farzamjahani/MachineDesign/matlab files/ComponentNames.txt

B12 B12 B13
B12 B12 B13
B12 GB GD
GA GB GD
GA GB GD
GA GC B23
B21 GC B23
B21 GC CG1
