farzamjahani/MachineDesign/GearBox.pdf

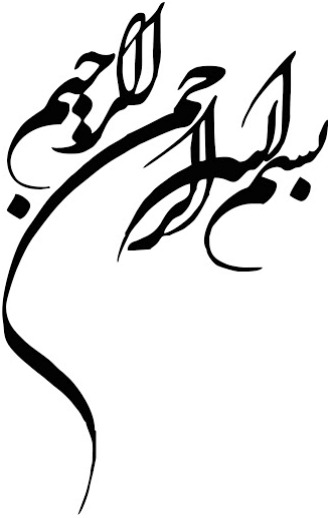
[picture p1: figure]

## گزارش پروژه

### عنوان پروژه:

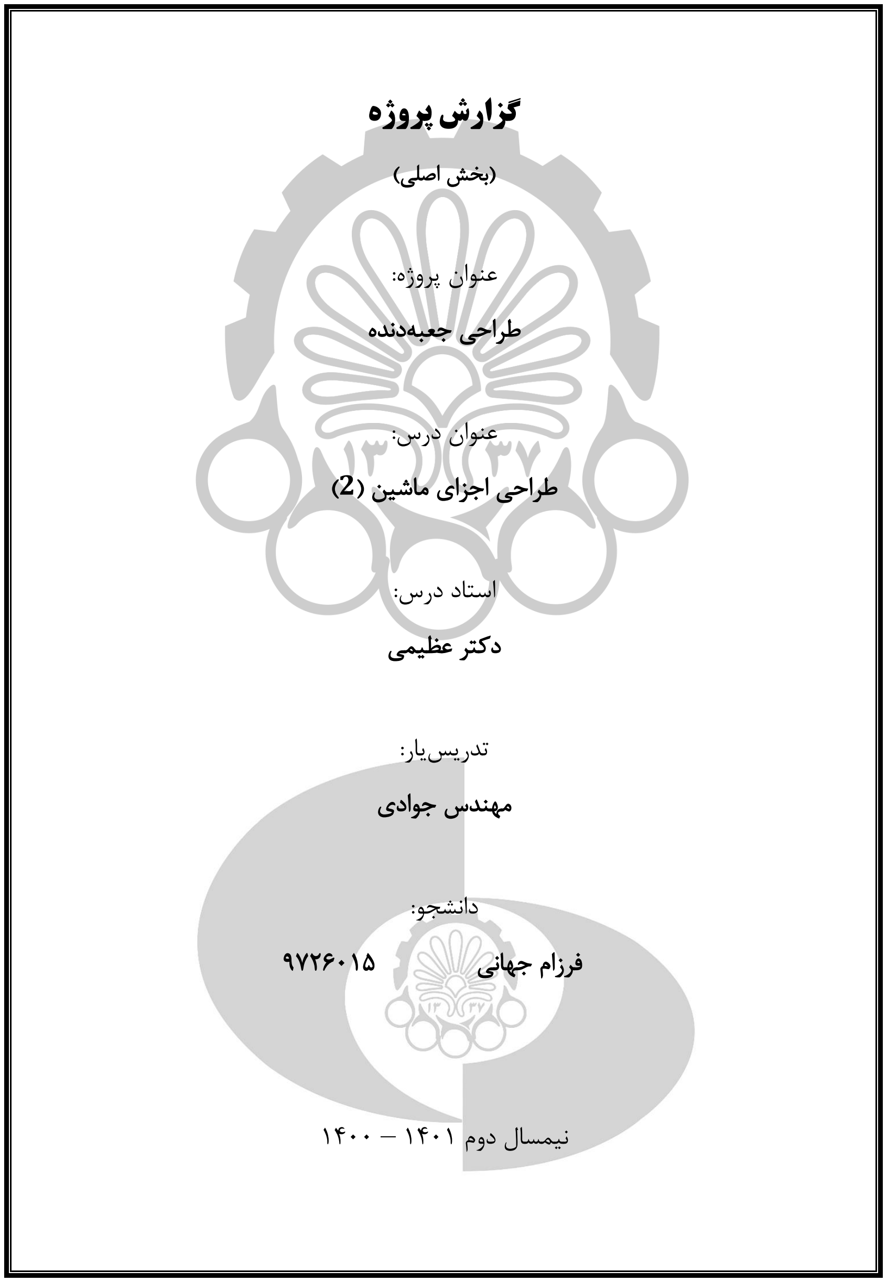
[picture p2: page 2]

)بخش اصلی(

### طراحی جعبه دنده

### عنوان درس: طراحی اجزای ماشین )2(

### استاد درس:

### دکتر عظیمی

### تدریسیار:

### مهندس جوادی

### دانشجو :

### فرزام جهانی 9726015

### نیمسال دوم 1401 – 1400

چکیده

### چکیده

با توجه به اهمیت سامانه های انتقال توان و نیرو در حوزه علم مکانیک، سامانه های متعددی نظیر جعبه دندهها معرفی شده اند. جعبه دندهها در اقسام متنوعی برحسب کاربرد ساخته میشوند. موضوع پروژه طراحی یک جعبه دنده سه محوره و دومرحله ای است. جعبه دنده ابزاری برای انتقال توان است که عمدتاً برای افزایش گشتاور مورد استفاده قرار می گیرد. قطعات بسیاری در این ابزار به کار گرفته می شود. چرخدنده، یاتاقان و شفت از اجزای حیاتی یک جعبه دنده هستند. این قطعات به همراه اجزای جانبی نظیر خارها به صورت تکتک طراحی گردیده، از آنان نقشه های ساخت تهیه شده و درنهایت به طور مناسب با یکدیگر مونتاژ خواهند شد. روش رایج برای طراحی های مکانیکی، طراحی برمبنای برآورده شدن استحکام الزم قطعات با فرض قطعیت کامل بوده و محاسبات آماری در این حالت وارد کار نخواه د شد. برای لحاظکردن و یا جبران عدم قطعیت در پارامترهای طراحی مانند عدم قطعیت در میزان بار وارده و خواص مواد، عاملی به نام ضریب اطمینان در طراحی جعبه دنده دخیل می گردد.

واژه های کلیدی

چرخدنده، شفت، خار، یاتاقان

فهرست مطالب

### فهرست مطالب

چک ی ده | أ
-1 فصل اول مقدمه 1 |
-2 فصل دوم داده ها و اطالعات 4 |
-3 فصل سوم فاز نخست پروژه 7 |
-4 فصل چهارم فاز دوم پروژه 12 |
-5 فصل پنجم فاز سوم پروژه 37 |
-6 فصل ششم خروجی نقشه ها 41 |

فصل اول: مقدمه

-1

## فصل اول مقدمه

فصل اول: مقدمه

### مقدمه

انسان همواره به دنبال تسهیلکردن امور روزمره است و برای انجام کارهایی که خارج از حد توانش باشند نیاز به افزایش توان دارد. بدین منظور از ماشینها و ابزارآالت استفاده می کند. امروزه برای انجام هرکاری به ماشین نیاز است. مهم ترین عضو یک ماشین، جعبه دنده آن است. تمام دستگاههای انتقال و افزایش قدرت دارای جعبه دنده هستند. جعبه دنده سازوکاری است که گشتاور ورودی را دریافت نموده، آن را افزایش داده و در قسمت خروجی تحویل می دهد. بنابر انتقال توان ثابت، افزایش گشتاور از طریق کاهش سرعت دورانی محور
1 | ورودی انجام می گیرد؛ لذا این نوع از جعبه دنده ها به جعبه دنده کاهنده
نامیده می شوند.
هدف از انجام پروژه طراحی یک جعبه دنده کاهنده دومرحلهای به همراه سامانه های ورودی و خروجی توان است. این جعبهدنده حامل سه محور )شفت( خواهد بود که محور ورودی آن، توان الکتروموتور را از طریق کوپلینگ وارد جعبه دنده نموده و پس از انجام دو مرحله کاهش سرعت به وسیله دو جفت چرخدنده مارپیچ، محور خروجی توان را برای مصرف خارج می گرداند. برای سامان دهی به فرایند طراحی این مجموعه پیچیده، در ابتدا نیاز است تا مراحل طراحی به چند فاز طراحی قطعات تقسیم بندی گردند. این کار عالوه بر تسهیل نمودن فرایند طراحی، به روش مند بودن انجام عملیات ها نیز کمک می کند. فازهای طبقه بندیشده شامل طراحی پنج بخش عمده طرح می شود که عبارت اند از:
- فاز اول: طراحی چرخدنده ها
- فاز دوم: طراحی شفت ها
- فاز سوم: انتخاب یاتاقان ها
- فاز چهارم: انتخاب کوپلینگ الزم به توضیح است که فرایند طراحی یک فرایند رفت و برگشتی است و به همین علت فازهای تفکیک شده به صورت مستقل در یک مسیر متوالی پیش نمی روند و بر یکدیگر تاثیر می گذارند. لذا برای شروع کار از فاز نخست شروع نموده و در مسیر انتقال توان به ترتیب فازها طی می شوند و در هر نقطه از مسیر طراحی امکان بازگشت به عقب برای تصحیح و یا بازبینی طرح وجود دارد.

1
reducer

فصل اول: مقدمه

شرح روش انجام پروژه
تمام محاسبات مورد نیاز در پروژه و سعی وخطاهای طراحی با استفاد ه از نرم افزار مهندسی MATLAB انجام گرفته است. استفاده از نرم افزار رایانه ای عالوه بر صرفه جویی در زمان ، موجب کاهش خطای انسانی و همچنین سرعت بخشیدن به فرایند انتخاب طرح مناسب نیز می شود. از طرفی نیز نباید نقش انسان به عنوان طراح به طور کامل نادیده گرفته شود؛ چرا که هیچ نرم افزاری نمی تواند جایگزین تفکر انسانی گردد. لذا فرایند طراحی در قالب یک برنامه تعاملی با کاربر انجام می گیرد؛ بدین صورت که پارامترهای پراهمیت در طراحی توسط برنامه از کاربر درخواست شده و با استفاده از آن محاسبات طراحی اجرا میگردد. درنهایت نتایج محاسبات به کاربر نمایش داده شده و با تصمیم وی روند طراحی ادامه می یابد. سعی شده است تا حد امکان برنامه طراحی پروژه عمومی باشد اما برای پرهیز از طوالنی شدن روند انجام پروژه و کاهش پیچیدگی های غیرضروری، ویژگی های مختص پروژه ِ پیش رو را پشتیبانی میکند. البته استفاده از رایانه برای انجام محاسبات میتواند روند طراحی را ماژوالر نماید؛ به طوری که با کمی تغییر در متن برنامه، آن را برای استفاده در سایر پروژه ها نیز معتبر می کند.

پس از انجام فرایند طراحی در هر فاز و دستیابی به طرح بهینه بعد از چندین بار سعی وخطای معقوالنه، نتایج خروجی از برنامه ثبت گردیده و پس از اعتبارسنجی آنان و بازبینی مجدد روند انجام پروژه، وارد مرحله نهایی سازی خواهد شد. در این مرحله ابعاد و اندازه های طرح به دست آمده و آماده تهیه نقشه های ساخت و مدلسازی سه بعدی خواهد بود که درنهایت این نقشه ها به همراه جزئیات برای ساخت ارسال می گردند. نرم افزار مورد استفاده در پروژه برای مدلسازی و تهیه نقشه ها، نرمافزار مدل سازی solidworks خواهد بود. فرض اساسی که در طول فرایند طراحی جعبه دنده در نظر گرفته شده است، نادیدهگرفتن تمام اتالف های مجموعه و لحاظ کردن بازدهی صد درصد برای کل قطعات درگیر در انتقال قدرت از موتور تا خروجی گیربکس است. کما اینکه به علت باال بودن بازدهی قطعات دندانه دار )نظیر چرخدنده ها(، این فرض معتبر خواهد بود. همچنین فرض می شود الکتروموتور متصل به دستگاه، به صورت تمام قدرت کار نموده و خاموش و روشن نمیشود.

فصل دوم: دادهها و اطالعات

-2

## فصل دوم داده ها و اطالعات

فصل دوم: دادهها و اطالعات

### داده ها و اطالعات

طرح نمادین یک جعبه دنده دومرحله ای به همراه دستگاه مختصات نظیرشده به آن، در شکل -2 1 نشان داده شده است. این جعبهدنده تک سرعته بوده و سامانه های انتقال توان در ورودی و خروجی آن به ترتیب به صورت مجموعه تسمه- قرقره و مجموعه زنجیر -چرخ زنجیر هستند. پیش از شروع طراحی الزم است تا قطعات و اجزای موجود در سامانه نامگذاری و توجیه گردند . بنابراین در مسیر جریان انتقال قدرت یعنی از موتور تا ابتدای مصرف کننده، ش فت ها، قرقره ها و چرخ زنجیرها به ترتیب تعداد با یک عدد، یاتاقانها به ترتیب تعداد بر روی هر شفت با دو عدد و چرخدندهها به ترتیب حروف الفبای انگلیسی نامیده می شوند. شیوه نامگذاری قطعات در راهنمای شکل -2 1 توضیح داده شده است.

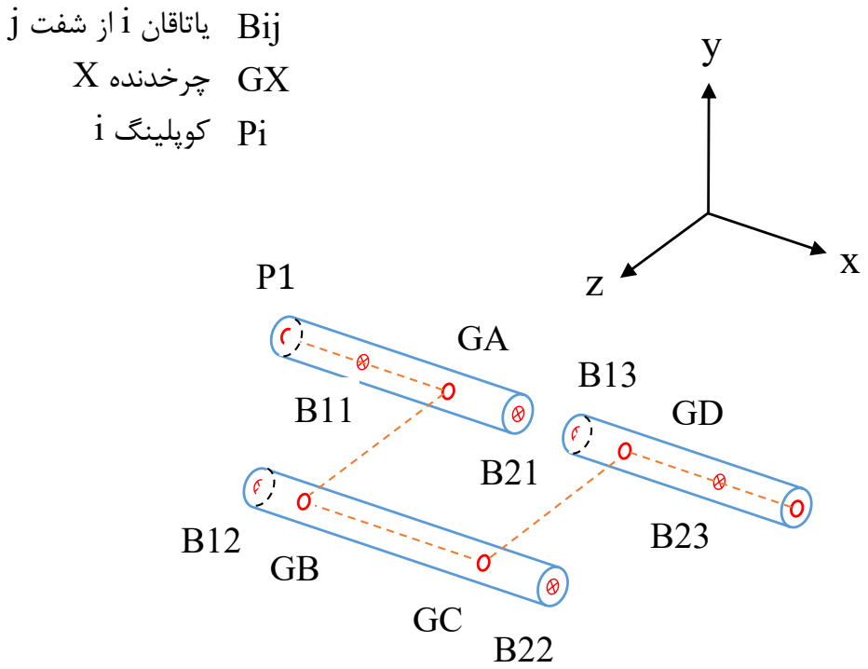
[picture p3: figure]
Bij یاتاقان i از شفت j; چرخدنده; کوپلینگ

شکل -1-2 طرح واره کلی از جعبه دنده

فصل دوم: دادهها و اطالعات

شرح داده ها و اطالعات

جعبه دنده توان را از یک موتور الکتریکی 1360 وات )باتوجه به شماره داشنجویی( در دور نامی 1450 دور بر دقیقه دریافت کرده و به شفت خروجی انتقال می دهد. نسبت تبدیل سرعت جعبه دند ة کاهنده در حدود 2% ± 11.9( باتوجه به شماره داشنجویی( است.

جعبه دنده و الکتروموتور آن دارای بارهای ضربه ای متوسط هستند که عمر مدنظر برای کل سامانه 10 سال در یک شیفت کاری لحاظ میشود. یک شیفت کاری معادل 8 ساعت در روز و هر سال مشتمل بر 300 روز کاری است.

ضریب اطمینان این مجموعه برابر 3 بر روی بار درنظر گرفته خواهد شد و قابل اطمینان مجموعه یاتاقان های این جعبه دنده حداقل %90 مورد انتظار است. در طراحی این مجموعه انتقال قدرت سعی می شود تا حد ممکن از پدیده شکارچی پرهیز شود. جعبه دنده توسط چهار پیچ اتصال به شاسی متصل می گردد و مطلوب این است که در کوچکترین اندازه طراحی شود.

تمامی چرخدندههای به کاررفته در این جعبه دنده از نوع مارپیچ با زاویه فشار نرمال 20 درجه هستند. به عالوه، زاویه مارپیچ دنده ها عددی صحیح در بازه 15 تا 30 درجه مطلوب است. جنس دنده چرخدنده ها از فوالد 4140 AISI و گرید 2 در نظر گرفته می شود. هم چنین میتوان عدد سختی برینل دنده های این چرخدندهها را تا 325 درنظر گرفت و با انجام سختکاری سطحی به سختی 50 RC رسید .

هر شفت درون این جعبه دنده با دو یاتاقان مهار می شود که محل قرارگیری آنان بر روی شفتها دلخواه است. یاتاقانها از نوع شیارعمیق یا متناسب با شرایط موجود می توانند از نوع غلتکی باش ند. منبع انتخاب یاتاقانهای سامانه از کاتالوگ SKF خواهد بود.

تمامی شفت ها از جنس 45CK هستند. این جنس که جزء جنسهای متداول شفت است، دارای استحکام حد نهایی برابر 660 مگاپاسکال و استحکام تسلیم برابر 470 مگاپاسکال خواهد بود. همچنین خارها همجنس با شفت و از نوع مربعی هستند.

فصل سوم: فاز اول پروژه طراحی چرخدندهها

-4

## فصل سوم فاز اول پروژه

فصل سوم: فاز اول پروژه طراحی چرخدندهها

### فاز اول پروژه )طراحی چرخدنده ها(

زیرسامانه چرخدنده ها در دو مرحله وظیفه افزایش بیشترین نسبت قدرت را در مجموعه بر عهده دارند. قلب تپنده یک جعبه دنده چرخدندههای آن است. انتقال توان با استفاده از چرخدنده ها مطمئنترین نوع انتقال توان است. هزینه ساخت چرخدندهها نسبت به سایر قطعات مشابه برای انتقال توان نسبتاً باالست. لذا اهمیت فوق العادهای در مجموعه پیدا می کنند. از میان اقسام پرشمار چرخدندهها، نوع مارپیچ آن به طور معمول در ساخت جعبهدنده استفاده میشود. چرخدندههای مارپیچ به نسبت چرخدندههای ساده در سرعتهای باال بار بیشتری تحمل می کنند و هم چنین تولید سروصدای کمتری نیز دارند. افزون بر این موارد، زاویه مارپیچ چرخدندههای آن ها نسبت به چرخدندههای ساده به عنوان پارامتری مهم در منعطف نمودن طراحی چرخدندهها تلقی می شود. در ازای این مزایا به علت مورب بودن دنده ها، چرخدندههای مارپیچ بار محوری بر شفت تحمیل می کنند. با تمام این تفاسیر در جعبه دنده مورد نظر از همین نوع چرخدنده بنابر خواسته کارفرما استفاده خواهد شد. معیار طراحی چرخدنده ها طبق روال معمول بر مبنای استاندارد AGMA خواهد بود. بدین طریق که طراحی چرخدنده بر مبنای سه اصل به ترتیب پرهیز از تداخل، تحلیل خستگی خمشی و تحلیل خستگی سطحی تحت شرایط عدم وجود پدیده شکارچی و رعایت محدوده نسبت تبدیل خواسته شده توسط کارفرما، انجام می گیرد.
با توجه به اینکه کارفرما درخواست طراحی کوچکترین حالت جعبه دنده را داده است، منطقاً برای دستیابی به این خواسته نسبت تبدیل هر دو مرحله کاهش سرعت در جعبه دنده، یکسان فرض می شود. حال اینکه قید همراستایی شفت ورودی و خروجی در پروژه وجود ندارد، آزادی در طراحی کمی بیشتر می شود اما با این وجود سعی می گردد عدم همراستایی شفت ورودی و خروجی در جعبه دنده تاحد ممک ن کم باشد . چراکه بیش از حد بودن عدم همراستایی شفتهای ورودی و خروجی جعبه دنده چندان مطلوب مشتری نیست. همین طور مدول انتخابی برای دنده ها از نوع ترجیحی گزینش خواهد شد و از انتخاب های بعدی برای مدول دنده ها استفاده نمی گردد.

فصل سوم: فاز اول پروژه طراحی چرخدندهها

شرح تابع طراحی چرخدنده
تابع طراحی زیرسامانه چرخدنده در قالب یک کد با نام HelicalGear تدوین شده است. این تابع ورودیهایی را دریافت نموده و با تعامل میان کاربر روند محاسبات و تکرارهای مورد نیاز این فاز را طی کرده و در نهایت نتیجه فرایند طراحی را به صورت خروجی های ماتریسی در اختیار فازهای بعدی پروژه قرار می دهد. ورودی های تابع چرخدنده بدین شرح هستند:
- توان نامی موتور برحسب وات
- دور نامی موتور برحسب دوربردقیقه
- ضریب اطمینان نهایی مجموعه فرایند طراحی هر مرحله کاهش سرعت برای هر جفت چرخدنده به صورت یک جا، متوالی و برمبنای سه اصل ذکرشده انجام می شود. در ابتدای محاسبات هر مرحله برای جفت چرخدندهها، زاویه مارپیچ دنده ها توسط کاربر وارد مسیر برنامه شده و به دنبال آن، تعداد چرخه )سیکل( چرخدنده محرک، زاویه فشار ظاهری و حداقل تعداد دندانه های چرخدنده محرک برای پرهیز از تداخل محاسبه می گردد. پس از آن برای دستیابی به تعداد دندانه های مناسب چرخدنده متحرک فرایندی تکراری انجام گرفته، دو شرط پرهیز از شکارچی شدن و رعایت بازه نسبت تبدیل درخواستی کارفرما بررسی شده و در صورت صادق بودن این قیود، برنامه با تعیین تعداد دندانه های مناسب برای هردو چرخدنده درگیر، از حلقه تکرار اول خارج می گردد. در حلقه اول برنامه این امکان را دارد که به صورت موضعی قبل از طراحی مرحله دوم، بر مبنای فرض یکسان در نظر گرفتن نسبت تبدیل، عدم رعایت نسبت تبدیل درخواستی کارفرما را به کاربر اطالع دهد. برای تحلیل خستگی خمشی دنده ها، پس از انجام محاسبات اولیه و وارد کردن اطالعات مورد نیاز توسط کاربر اعم از قابلیت اطمینان و نسبت پهنای دنده، برنامه وارد دو حلقه تکرار تودرتو شده تا حداقل مدول نرمال دنده ها با رعایت تمام شروطِ نامبرده حاصل شود. در ابتدای حلقه اول و پیش از ورود به حلقه دوم برمبنای اطالع از پهنای دنده و به کمک جدول 15-2 ] 2[ ، برنامه ضریب توزیع بار را وارد جریان محاسبات می کند. درون حلقه دوم با ورود یک مدول حدسی توسط کاربر، ضریب دینامیکی محاسبه شده و با دردست داشتن تمام ضرایب، حداقل مدول نرمال دنده حاصل می گردد و از کاربر تقاضا می شود مدول حاصلشده را با کمک مقادیر ترجیحی از جدول 13-2 ] 1[ تصحیح کند. با همگرایی مدول حدسی و مدول تصحیح شده توسط کاربر، برنامه حلقه درونی را ترک می کند.

فصل سوم: فاز اول پروژه طراحی چرخدندهها

برای تحلیل خستگی سطحی نیز مشابه قسمت تحلیل خستگی خمشی، تمام مراحل اجرا گردیده با این تفاوت که مدول شروع کار، همان مدول به دست آمده از تحلیل خستگی خمشی خواهد بود. مدول نرمال اولیه برای محاسبه ضریب هندسی دنده ها الزم است. به روال معمول در حلقه داخلی دوم نیز با همگرا شدن روند تکرار بر روی مدول نرمال، حلقه تکرار پایان می یابد. مدول نهایی هر جفت چرخدنده برابر بیشینه حد دو مدول نرمال محاسبه شده انتخاب میشود. در این حالت با داشتن مدول نرمال، پهنای دنده قابل حصول است و برنامه به ابتدای حلقه تکرار خارجی باز می گردد و براساس پهنای دنده، ضریب توزیع بار را مجدداً به روز می کند و در صورت تفاوت داشتن این ضریب، حلقه های داخلی تکرار می شوند و درغیر این صورت، برنامه با موفقیت حلقه های تکرار مدول یابی را خاتمه می دهد. پس از نهایی شدن مدول نرمال، پهنای دنده، فاصله مرکزتامرکز چرخدنده ها، قطرهای گام و ریشه هر چرخدنده از هر جفت محاسبه می شوند. قطر ریشه دنده ها برای تحلیل ضریب طوقه به کار می رود. بعد از اتمام طراحی هر دو مرحله، بار دیگر نسبت تبدیل نهایی جعبه دنده )حاصل از هر دو مرحله( چک شده و در صورت عدم رعایت بازه درخواستی کارفرما، پیغام هشدار برای کاربر ظاهر می گردد و می بایست فرایند طراحی فوق مجدداً اجرا شود.
خروجی های تابع چرخدنده برای هر مرحله )جفت چرخدنده( به شرح زیر هستند:
- تعداد دندانه چرخدنده ها
- نسبت تبدیل هر مرحله
- پهنای دنده ها برحسب میلی متر
- فاصله مرکزتامرکز چرخدنده ها برحسب میلی متر
- مدول نرمال برحسب میلی متر
- قطرهای گام و ریشه چرخدندهها برحسب میلی متر
- مشخصات دنده شامل قطرهای گام و زاویه مارپیچ چرخدندهها خروجی های تابع چرخدنده در قالب مقادیر ماتریسی برای فازهای بعدی طراحی ارسال می شوند.

فصل سوم: فاز اول پروژه طراحی چرخدندهها

نتیجه نهایی فاز دوم برای طراحی چرخدندههای مارپیچ در جدول -4 1 ثبت شده است.

جدول -1-4 مشخصات زیرسامانه چرخدنده های مارپیچ
| | | پارامتر مرحله اول مرحله دوم نماد
p | | | تعداد دندانه های pinion 13 13 N
g | | | تعداد دندانه های gear 45 45 N
− | left−hand | right−hand | pinion های دنده نوع
− | right−hand | left−hand | gear های دنده نوع
m n | 4 mm | 3 mm | نرمال مدول
ψ | 20° | 20° | مارپیچ زاویه
| | .4615 3.4615 ~ mG | نسبت تبدیل 3 ~
| | | پهنای دنده ها mm 24 mm 48 b
C | ~ 123.44 mm | ~ 92.58 mm | ها چرخدنده مرکزتامرکز HG
| ~ 55.33 mm | ~ 41 .5 mm | pinion گام قطر d
| ~ 191.55 mm | ~ 143 .66 mm | gear گام قطر D
d r | ~ 45.3 mm | ~ 34 mm | pinion ریشه قطر
D r | ~ 181.55 mm | ~ 136.16 mm | gear ریشه قطر
| .981 HG,TR | | نسبت تبدیل نهایی 11 ~
− | ~ 0.19% | | میزان خطا ی نسبت تبدیل جعبه دنده
− | ~ 30.86 mm | | میزان عد م همراستایی شفت ورودی و خروجی

فصل چهارم: فاز دوم پروژه طراحی شفت ها

-6

## فصل چهارم فاز دوم پروژه

### فاز دوم پروژه )طراحی شفت های جعبه دنده(

شفتهای یک جعبه دنده وظیفه انتقال توان از میان قطعات درگیر را بر عهده دارند. همچنین نیروهای اعمالی از طرف قطعات را به یاتاقان های مجموعه منتقل می کنند. حیاتی ترین و بحرانی ترین قطعات در جعبه دنده، شفتها هستند؛ زیرا به علت دوران، شدیداً تحت تاثیر اثرات خستگی، به دلیل مقاطع مختلف و جای خارها به شدت تحت اثرات تمرکز تنشی و هم چنین در معرض انواع بارگذاری ها از قبیل خمشی، برشی، پیچشی و محوری قرار دارند.
فرایند طراحی شفت به میزان بیشتری نسبت سایر قطعاتِ طراحی شده به تکرار و سعیو خطا نیاز دارد. برای تعیین معادالت، تنها اثرات خستگی در نوع بارگذاری خمشی و پیچشی بررسی می شود و از اثرات برشی نیروهای برشی صرف نظر خواهد شد. هم چنین زمانی که خمش در شفت حضور دارد، اثرات تنش محوری نیروی محوری ناشی از چرخدنده مارپیچ )یا یاتاقان مخروطی( ناچیز است و می توان از آن چشم پوشی نمود.
1 | بنابراین بارگذاری خمشی در شفت به صورت متناوب
)اندازه بیشینه و کمینه خمش یکسان( و بارگذاری
2 | پیچشی به صورت مکرر
)کمینه پیچش برابر صفر( لحاظ خواهد شد.
طراحی شفت های جعبه دنده در دو بخش انجام می گیرد؛ 1( محاسبه نیروهای تکیه گاهی و توزیع گشتاور خمشی در شفت 2( تعیین قطر مقاطع شفت و طراحی خارهای قطعات

1
completely reversed loading

2
repeated loading

-1 محاسبه نیروهای تکیه گاهی و توزیع گشتاور خمشی در شفت

برای محاسبه نیروهای تکیه گاهی و گشتاور خمشی در شفت نیاز است تا فواصل میان قطعات نصبشده بر روی شفت، پهنای قطعات و هم چنین طول نهایی شفت مشخص باشد اما در حال حاضر این اطالعات در دسترس نیستند. بنابراین با تکیه بر فرضیات و استفاده از طرح های ساختهشده میتوان تخمینی از این ابعاد به دست آورد، با آن فرایند طراحی را به پیش برد و طی چندین مرحله سعی وخطا بر روی انواع پرشماری از متغیرها، به طرحی معقول دست یافت. عمده فرضیات مقدماتی برای دستیابی به طرح اولیه شفت ها از این قرار هستند: با تحلیل کاتالوگ SKF می توان مالحظه نمود یاتاقان های شیارعمیق و غلتک استوانهای در قطرهای 15 تا 50 میلی متر دارا ی حداکثر پهنای 20 میلی متر خواهند بود. لذا با لحاظ کردن بدترین حالت و با توجه به اینکه قطر مقاطع شفت در این جعبه مورد نظر حداکثر در حدود 50 میلی متر خواهد بود، پهنای یاتاقان ها برابر 20 میلی متر درنظر گرفته می شود. )روش طراحی برمبنای بدترین حالت، روش مناسبی برای طراحی نیست اما می تواند حد نهایی برخی پارامترهای طراحی را مشخص نماید( میان لبه پله و جای خار فنری و همین طور برای طول پله وسط شفت های ورودی و خروجی فاصله ای به اندازه 10 میلی متر منظور می گردد. طول پله وسط شفت میانی با توجه به مالحظات قرارگیری یاتاقان های دو شفت ورودی و خروجی و با کمک ابعاد تخمینی برابر 80 میلی متر لحاظ می شود. با بررسی ابعاد قطعات منتقل کننده توان و توجه به پهنای نسبتاً زیاد چرخدنده ها ، نیاز این قطعات به نافی محسوس و منطقی نیست لذا جایی برای نافی لحاظ نمی شود )شایان ذکر است تمام شفت های مجموعه اعم از شفت های داخل جعبه دنده، شفت موتور و شفت مصرف کننده همگی در یک صفحه واقع میشوند.(

الف( تحلیل نیرویی شفت نخست )شفت ورودی( با توجه به فاصله نسبتاً کوتاه میان مراکز قرقره ها، زاویه انحراف تسمه از افق قابل مالحظه خواهد بود. این زاویه انحراف با α نامگذاری شده و در شکل -6 1 قابل مشاهده است. هم چنین تسمه از هر دو سمت به قرقره و در نتیجه به شفت نخست نیرو وارد می کند. دقت شود در نمودارهای آزاد دوبعدی، مختصات نماهای جانبی ترسیم شده است.

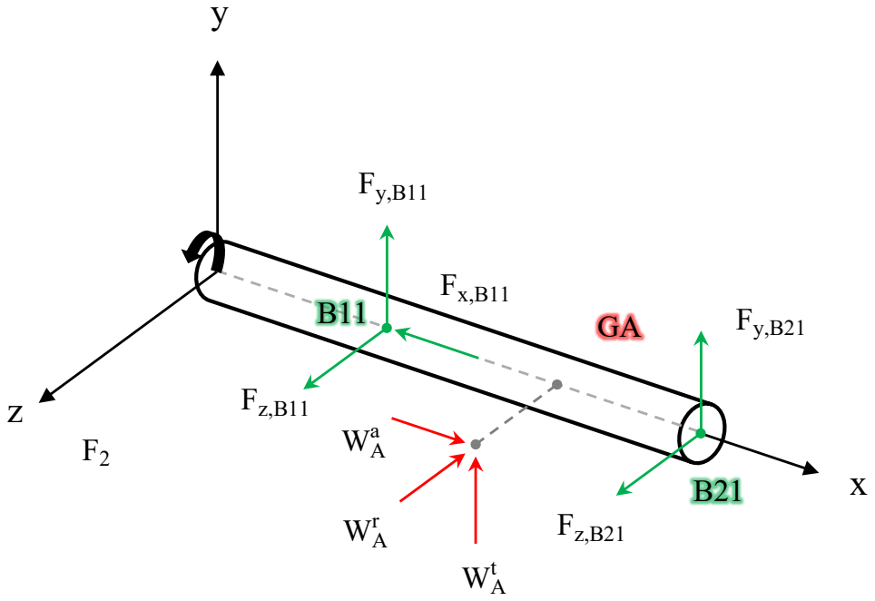
[picture p4: figure]
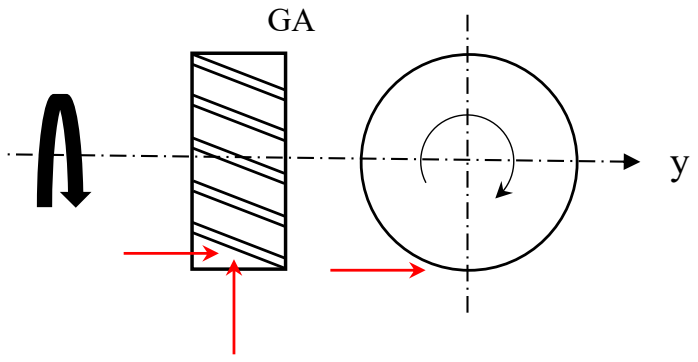
[picture p5: figure]

شکل -6 -1 نمودار آزاد شفت نخست و قطعات آن

ب( تحلیل نیرویی شفت دوم )شفت میانی ( در شفت دوم زاویه مارپیچ دندههای چرخدنده GC باید به گونه در نظر گرفته شود که نیروی محوری اعمالی به این شفت توسط هر دو چرخدنده، در کمترین حالت ممکن باشد. یعنی نیروی محوری اعمالشده به چرخدندههای GB و GC در خالف جهت یکدیگر باشند .

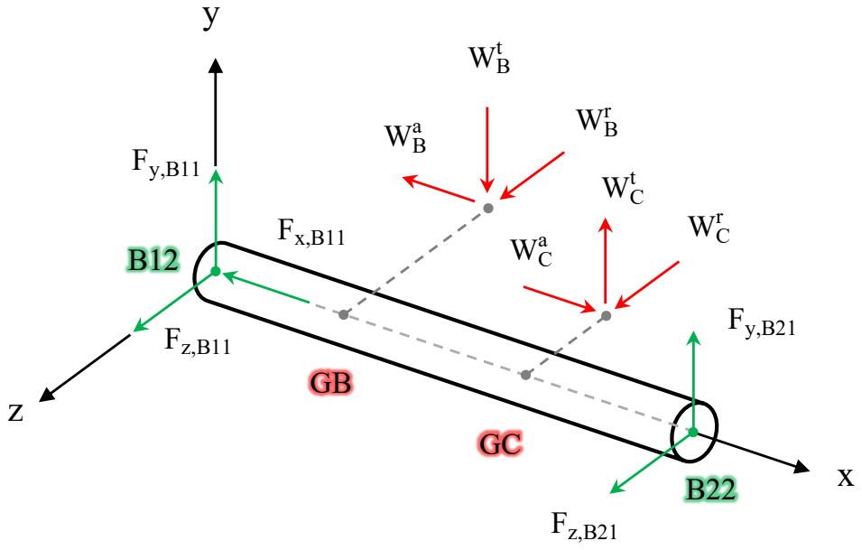
[picture p6: figure]
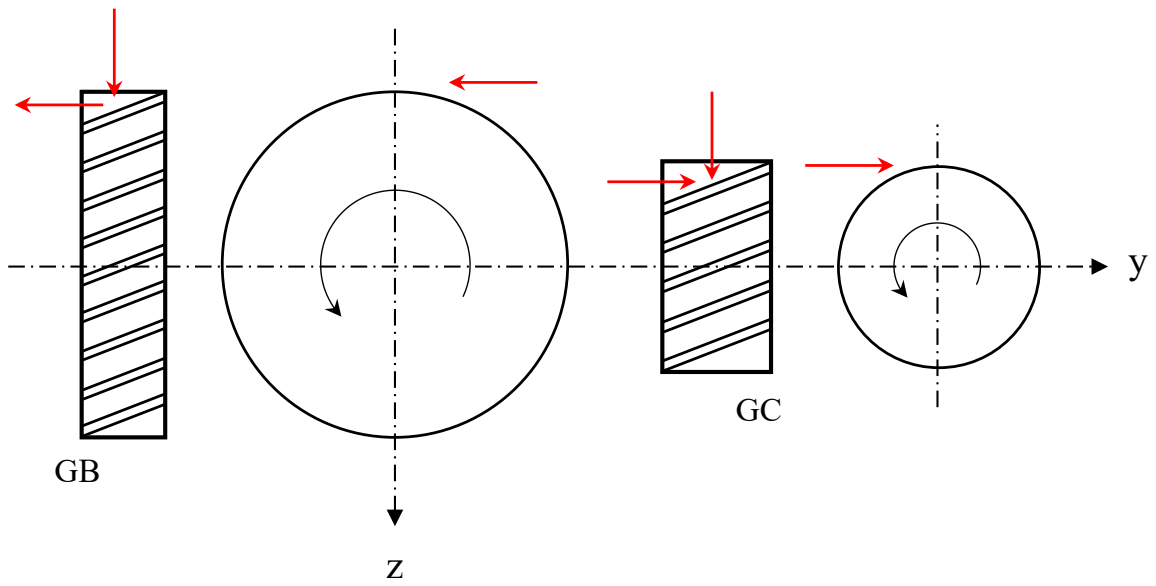
[picture p7: figure]

شکل -6 -2 نمودار آزاد شفت دوم و قطعات آن

ج( تحلیل نیرویی شفت سوم )شفت خروجی ( مشابه زیرسامانه تسمه-قرقره، فاصله مرکزتامرکز میان چرخ زنجیرهای مجموعه نیز کوتاه است و بنابراین زاویه انحراف زنجیر قابل اغماض نیست. زاویه انحراف زنجیر از راستای افق با β نامیده می شود که در شکل -6 3 نمایش داده شدهاست. در تعیین نیروی اعمالی زنجیر به چرخ زنجیر فرض می شود سمت آویختة زنجیر به علت شناوری، نیرویی بر شفت وارد نمی کند. لذا تنها زنجیر از یک سمت بر چرخ زنجیر و درنتیجه بر شفت سوم

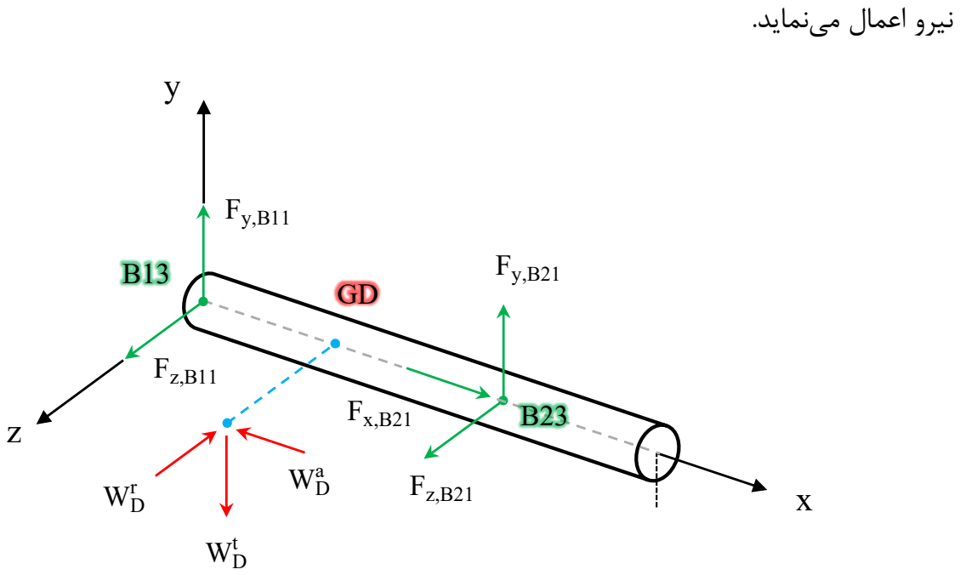
[picture p8: figure]
نیرو اعمال می نماید.
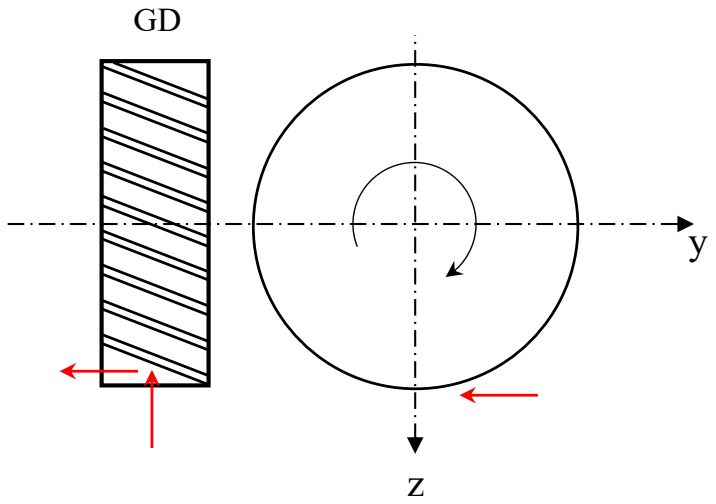
[picture p9: figure]

شکل -6 -3 نمودار آزاد شفت سوم و قطعات آن

شرح ت و ابع تحلیل نیرویی شفت ها توابع تحلیل نیرویی شفت ها در قالب سه کد جداگانه با نام اسامی هر شفت تدوین شدهاست. به علت این که قطعات نصب شده بر روی هر شفت و نحوه قرارگیری آن ها متفاوت است، برای پرهیز از پیچیدگی های بیمورد سه تابع مجزا به این قسمت از فاز چهارم اختصاص می یابد. این توابع هرکدام ورودی های مشابهی را دریافت نموده و بدون هیچ گونه تعامل با کاربر، نیروهای تکیه گاهی و توزیع گشتاور خمشی در طول شفت ها را محاسبه می نمایند. همچنین نمودار گشتاورهای خمشی در راستاهای عمود بر محور شفت و گشتاور نهایی را ترسیم می کنند. ورودی های توابع تحلیل نیرویی شفت ها عبارتند از:
- اطالعات مقدماتی مشابه توابع پیشین )توان و دور نامی موتور(
- نسبت تبدیل هر بخش انتقال قدرت به صورت مجزا
- فواصل تخمینی میان قطعات شفت در قالب یک بردار پنج مولفه ای
- متغیر حامل اطالعات چرخدندهها نظیر قطر گام و زاویه مارپیچ به صورت ماتریس دو در سه
- نیرو)ها( و زاویه انحراف نیرو در قطعات بیرونی جعبه دنده برای شفت اول و سوم در ابتدای کار، نیروی وارده به هر چرخدنده توسط اطالعات ورودی به مولفه های مماسی، شعاعی و محوری تجزیه می شود. سپس هر تابع با استفاده از معادالت تعادل واکنش های تکیه گاهی در محل یاتاقانها را تعیین می کند. نیروی محوری تحمیلشده بر شفت نیز تعیین میشود تا در انتخاب یاتاقان مورد استفاده قرار بگیرد. با تعیین تمام نیروهای اعمالی بر شفت، می توان توزیع گشتاور خمشی در راستاهای عمود بر محور شفت را به دست آورد. برای این کار فواصل میان هر قطعه بر روی شفت با مقیاس 0/01 میلی متر و به کمک متغیرهای مجزا تقسیم بندی می گردد. در ادامه، فواصل تقسیم بندیشده با یکدیگر تجمیع گردیده و به عنوان دامنه تغییر در طول شفت برای نمایش و تخصیص گشتاورهای خمشی به کار می رود. در پایان برنامه نیز می توان نمودار گشتاور خمشی در دو راستای عمود بر محور شفت و گشتاور نهایی هر شفت در طول شفت را از برنامه دریافت نمود. خروجی های توابع تحلیل نیرویی شفتها بدین شکل هستند:
- واکنش های تکیه گاهی شفت در قالب یک بردار دومولفه ای
- خالص نیروی محوری اعمالشده بر شفت
- توزیع گشتاور خمشی نهایی در طول شفت

الف( ترسیم نمودارهای گشتاور خمشی برای شفت اول نمودارهای گشتاور خمشی در دو راستای عمود بر محور شفت و هم چنین گشتاور نهایی در طول شفت اول در شکل -6 4 ترسیم شده اند.

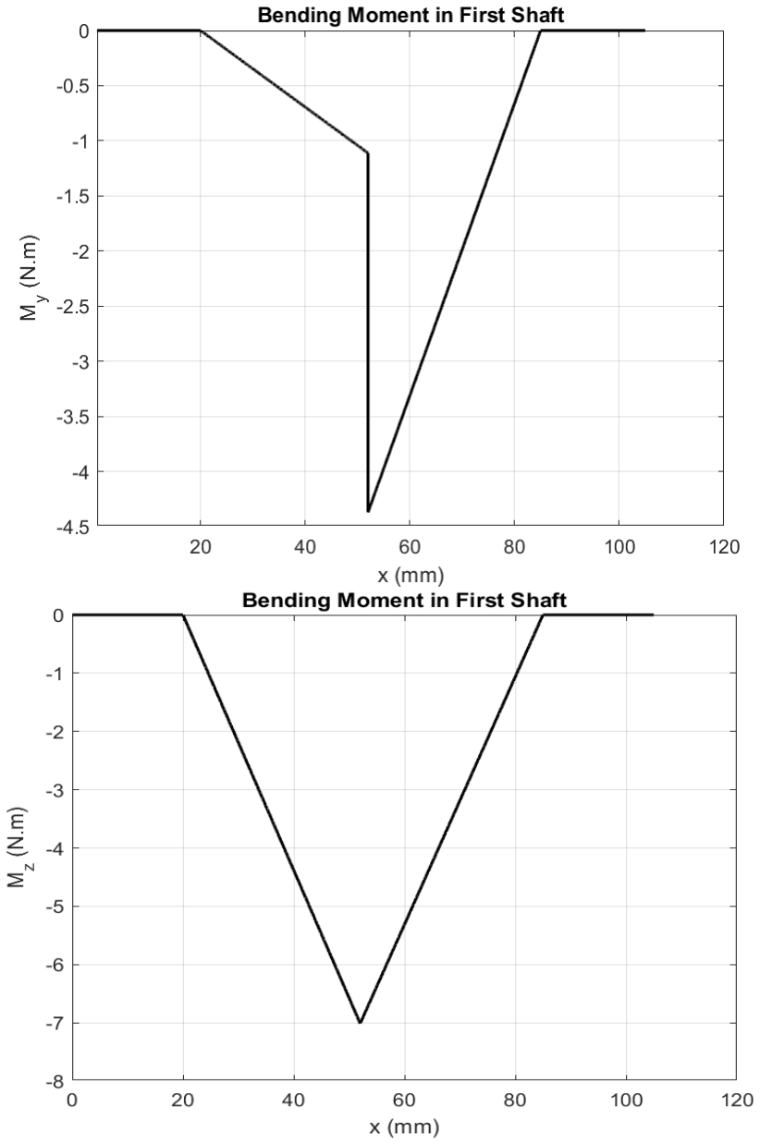
[picture p10: figure]

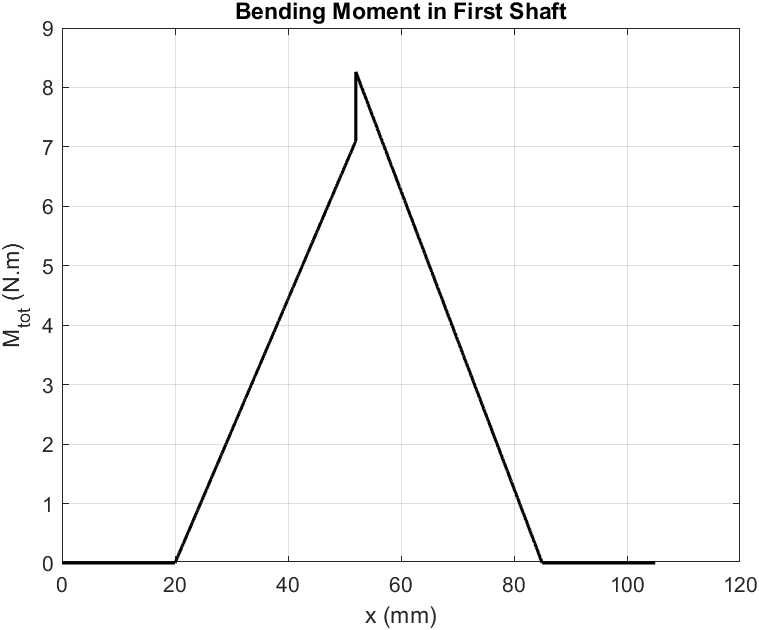
[picture p11: figure]

شکل -6 -4 نمودارهای گشتاور خمشی در طول شفت اول

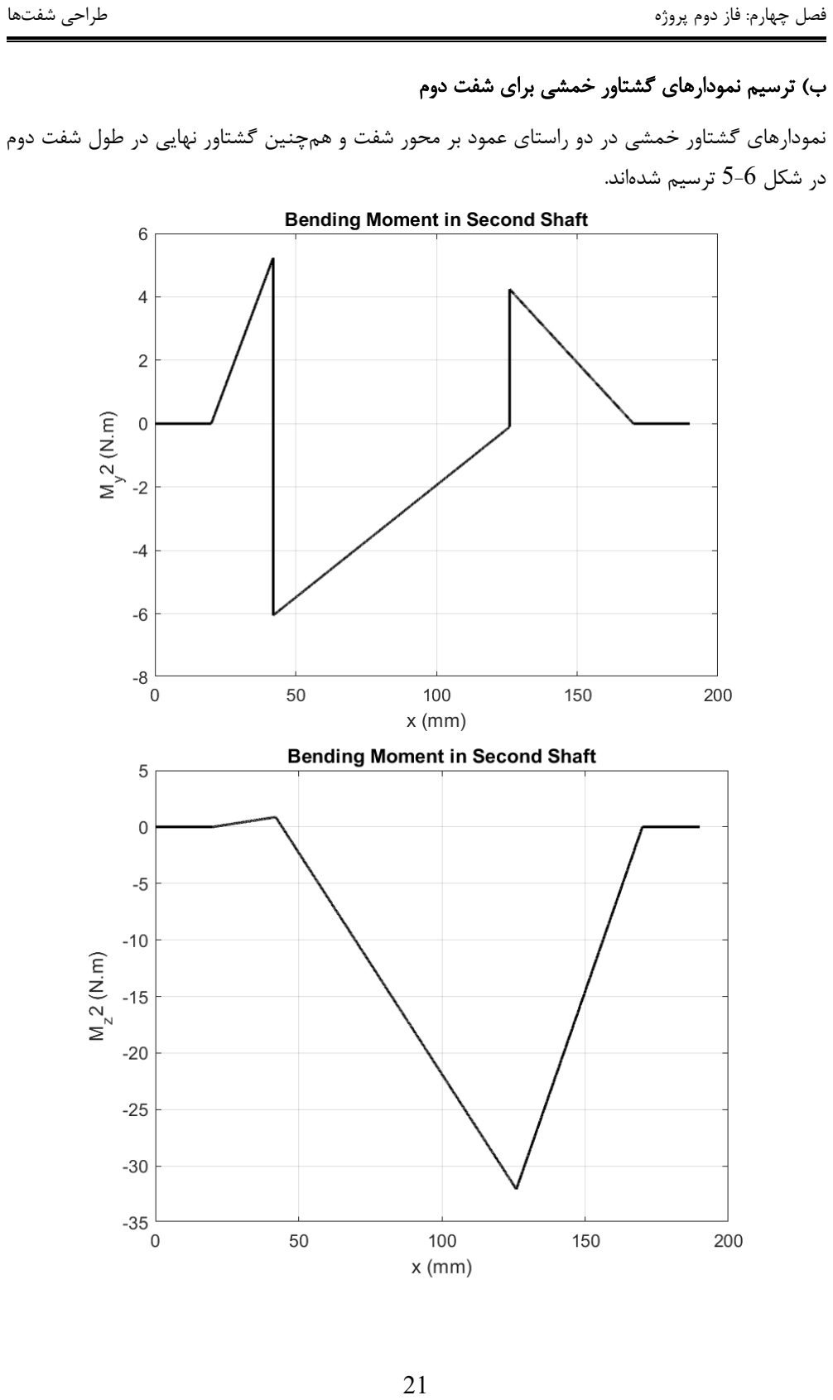
[picture p12: page 25]

ب( ترسیم نمودارهای گشتاور خمشی برای شفت دوم نمودارهای گشتاور خمشی در دو راستای عمود بر محور شفت و هم چنین گشتاور نهایی در طول شفت دوم در شکل -6 5 ترسیم شده اند.

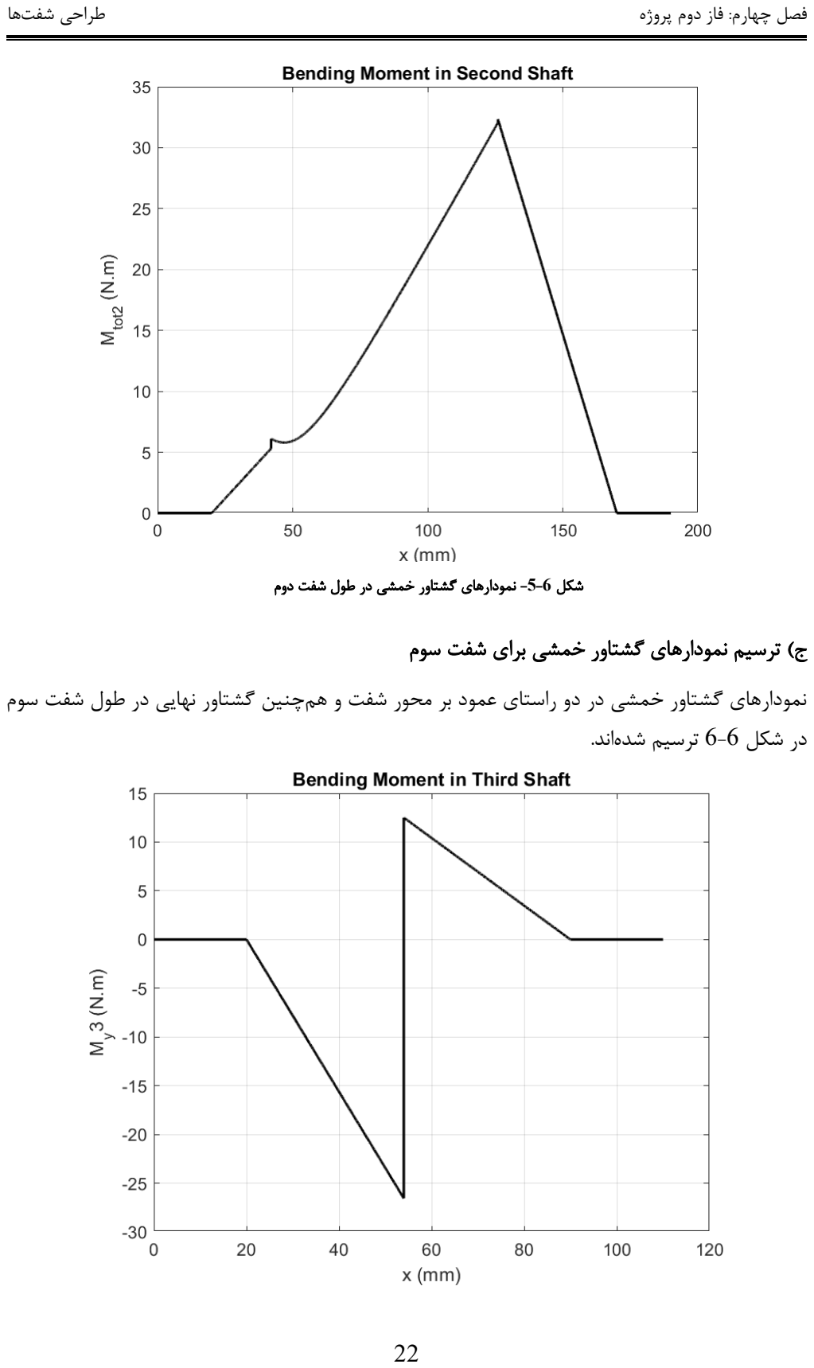
[picture p13: page 26]

ج ( ترسیم نمودارهای گشتاور خمشی برای شفت سوم نمودارهای گشتاور خمشی در دو راستای عمود بر محور شفت و هم چنین گشتاور نهایی در طول شفت سوم در شکل -6 6 ترسیم شده اند.

شکل -6 -5 نمودارهای گشتاور خمشی در طول شفت دوم

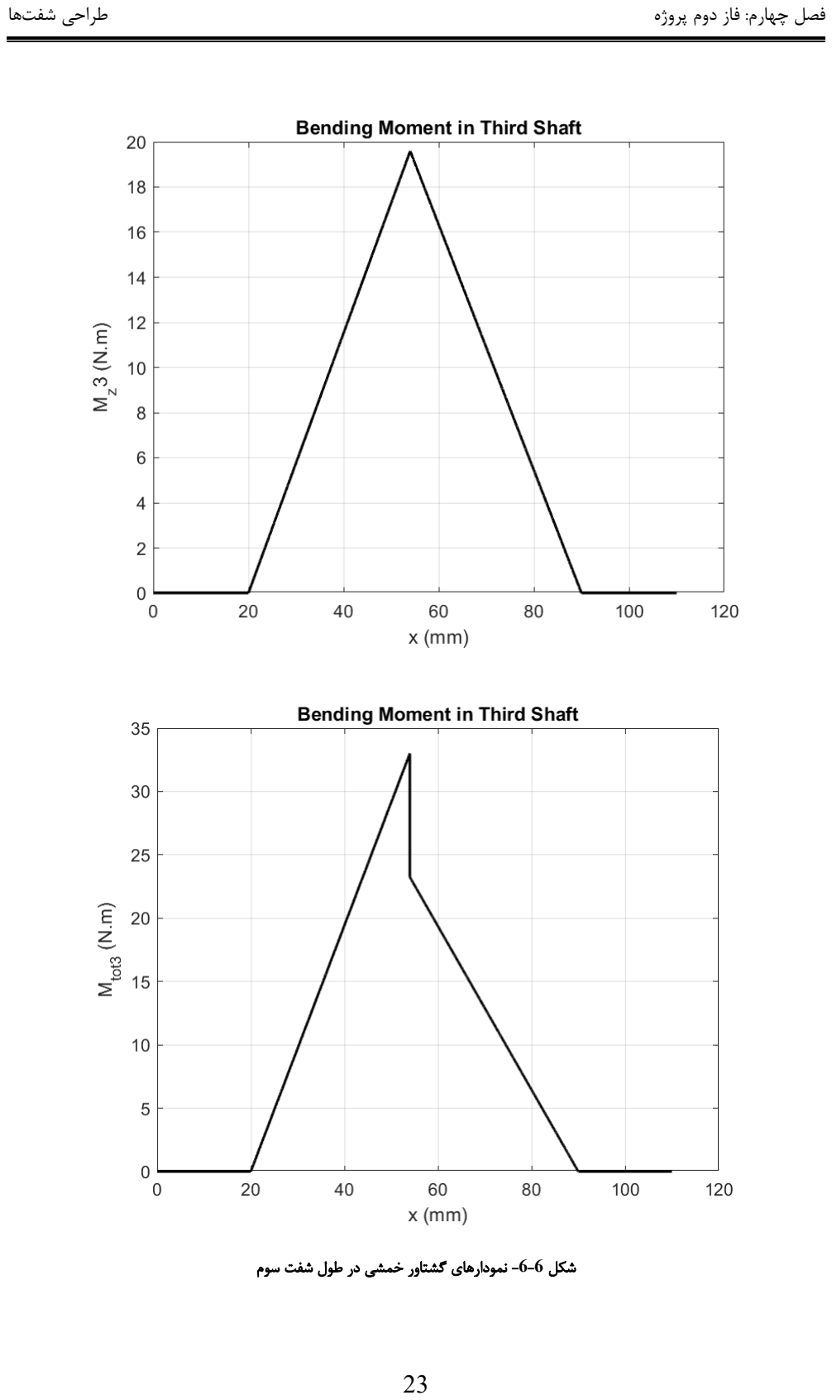
[picture p14: page 27]

شکل -6 -6 نمودارهای گشتاور خمشی در طول شفت سوم

-2 تعیین قطر مقاطع شفت و طراحی خارهای قطعات

برای تعیین قطر مقاطع مختلف شفت در ابتدا نیاز است تا یک چینش تخمینی برای شفت و قطعات نصب شده بر روی آن لحاظ گردد. سپس بر مبنای چینش اولیه و با استفاده از نقاط بحرانی روی شفت قطر مقاطع در طی فرایند سعی و خطا به دست می آید. نقاط بحرانی شفت در دو دسته ذیل قابل تصور هستند :

- نقاط تمرکز تنش به سه صورت جای خار فنری، جای خار مستطیلی و پله
- نقطه دارای بیشینه گشتاور خمشی در طول شفت در هر شفت ده نقطه تمرکز تنش و تنها یک )یا به ندرت دو( نقطه حامل بیشترین گشتاور خمشی یافت می گردد. در برخی موارد ممکن است نقطه ای که در معرض بیشینه گشتاور خمشی قرار می گیرد، دارای تمرکز تنش نیز باشد. ده نقطه ای که تمرکز تنش دارند به »نقاط ده گانه« نامگذاری می گردند و در شکل 4-6 مشخص گردیده اند . )جای خارهای فنری شفت برای وضوح بیشتر به صورت کامالً منحنی و با اغراق نمایش داده شده اند(

شکل -7-6 نمایش نقاط تمرکز تنش بر روی شفت ها )نقاط ده گانه(

1 | 2 | 3 4 | 5 | 6 | 7 | 8
1 | 2 3 | 4 | 5 | 6 | 7 | 8 9 | 10
1 | 2 | 3 | 4 | 5 | 6 | 7 | 8

ضرایب تمرکز تنش

پس از مشخص نمودن نقاط بحرانی با استفاده از معیار استحکامی سادربرگ در ابتدا با تخمینی برای قطر یکی از نقاط )پله دوم هر شفت( و در چند مرحله سعی و خطا، یک مقدار برای استحکام حد دوام شفت محاسبه می شود و با استفاده از آن قطر اولیه مقاطع شفت به دست می آید. استحکام حد دوام شفت وابسته به قطر است و درنهایت با سعی وخطا برای هر شفت، چهار مقدار گزارش می گردد. در این مرحله نیاز است تا ضرایب تمرکز تنش نقاط ده گانه معلوم شود اما پیش از تعیین قطر مقاطع این کار امکانپذیر نیست؛ بنابراین با حدس اولیه برای ابعاد و شعاع انحنای آن ها می توان مقادیر تخمینی و در عین حال محتاطانه را درنظر گرفت. پس با فرض های منطقی برای هرکدام روند طراحی را پیش برده و پس از دستیابی به ابعاد مورد نیاز، تمامی آن ها برای تکرارهای بعدی به روز می شوند.

1( پله
با فرض نسبت دو قطر پله برابر /2 1 و نسبت شعاع راکورد پله به قطر کوچکتر برابر ،0/02 ضرایب تمرکز تنش خستگی برای خمش و پیچش به ترتیب برابر /05 2 و /85 1 در نظر گرفته می شود.
Kf,steps ≈ 2.05 | , | Kfs,steps ≈ 1.85
2( جای خار مستطیلی

با فرض تراش جای خار مستطیلی با فرز انگشتی می توان ضرایب تمرکز تنش خستگی جاخار مستطیلی را برای خمش و پیچش به ترتیب برابر /8 1 و 1/7 در محاسبات لحاظ نمود.

Kf,keyseats ≈ 1.8 | , | Kfs,keyseats ≈ 1.7
3( جای خار فنری
با فرض نسبت دو قطر شیار برابر /1 1 و شعاع راکورد داخلی نسبت به قطر داخلی آن برابر 0/002 ضرایب تمرکز تنش خستگی برای خمش و پیچش به ترتیب 2 و /5 1 به دست می آیند.
Kf,grooves ≈ 2.0 | , | Kfs,grooves ≈ 1.5

ضرایب تمرکز تنش استاتیکی خمشی و برشی برای نهاییسازی به ترتیب از نمودارهای ذیل استخراج می گردند:

- پله -15-8الف ] 1[ -15-9الف ] 1[
- جاخار مستطیلی 5-1 ]5[ 5-2 ]5[
- جاخار فنری -15-16الف ]1[ -15-17الف ]1[

تعیین استحکام حد دوام

استحکام حد دوام برابر میزان تنش اعمالی است که با افزایش تعداد چرخه های بارگذاری، قطعه به شکست نمیرسد و در اصطالح دارای عمر نامحدود خواهد بود. برای قطعات فوالدی و آهنی استحکام حد دوام در میان تعداد چرخه بارگذاری حدودا یک تا ده میلیون دور رخ می دهد. استحکام حد دوامی که از نمودار استحکام-چرخه به دست می آید، در شرایط آزمایشگاهی است و برای تعیین آن در شرایط واقعی الزم است تا اصالح شود. بنابراین ضرایبی موسوم به ضرایب تصحیح Marin در حد دوام خام دخیل می شوند که در شش دسته طبقه بندی خواهند شد. حد دوام خام قطعه را در واحد بینالمللی می توان از رابطه -6 1 محاسبه نمود:

Se

'
= min{0.5Sut , 700 MPa} | )1-6(
برابر استحکام حد نهایی ماده برحسب مگاپاسکال است. | ut | که در آن S
بنابراین با توجه به جنس شفت و استحکام حد نهایی آن می توان نوشت:

Se

'
= 330 MPa

استحکام دوام نهایی ماده )استحکام حد دوام اصالح شده( را می توان از طریق رابطه -6 2 به دست آورد:

Se =(∏ki
f

i = a )Se

'
)2-6(

i که در آن k
ضرایب تصحیحی Marin و از قرار زیر هستند:

ka

ضریب پرداخت سطح

kb
ضریب اندازه

kc
ضریب بارگذاری

kd
ضریب اثرات دمایی

ke
ضریب قابلیت اطمینان

kf
ضریب عوامل متفرقه

ضرایب تصحیحی استحکام حد دوام بدین شرح هستند : -1 ضریب پرداخت سطح
روش متداول تولید شفت در صنعت به صورت ماشینکاری است و با توجه به این که شفتهای مجموعه با سطح نهایی ماشین کاریشده در نظر گرفته می شوند، می توان از رابطه 3-6 و با استفاده از پارامترهای متناسب در جدول 6-2 ]1[ ضریب پرداخت سطح را به دست آورد.

ka = aSut

b | )3-6(
که مطابق جدول مذکور می توان ضریب و نما را استخراج نمود:
a = 4.51 | , | b = −0.265
با توجه به جنس شفت و استحکام حد نهایی آن می توان نوشت:

ka ≈ 0.807
-2 ضریب اندازه
با توجه به نحوه بارگذاری بر روی شفت که از نوع خمشی و پیچشی هستند و همین طور هندسه سطح مقطع شفت که دایروی است، می توان ضریب اندازه را در واحد بینالمللی از رابطه 4-6 محاسبه نمود.

kb = {
(
| d 7.62) | −0.107 2.79 ≤ d ≤ 51 mm

1.51d

| | −0.157 5 1 < d ≤ 254 mm

)4-6(

که در آن d برابر قطر شفت است و ضریب اندازه در یک فرایند سعیو خطا همراه با تحلیل استحکام حد دوام شفت محاسبه خواهد شد.

-3 ضریب بارگذاری
با توجه به این که بارگذاری روی شفت از نوع خمشی با ترکیب سایر بارگذاری هاست، ضریب بارگذاری در این مورد برابر 1 لحاظ می گردد.

kc = 1

-4 ضریب دمایی
دمای قطعه عامل مهمی در شکست محسوب می شود به ویژه این که می تواند رفتار شکست ماده را نیز تغییر دهد. با توجه به اینکه شرایط کارکرد مجموعه در دمای متوسط است:

kd ≈ 1
-5 ضریب قابلیت اطمینان
قابلیت اطمینان نقطه مقابل احتمال شکست است؛ به طوری که هر چه احتمال شکست کمتر باشد، قابلیت اطمینان بیشتر است. احتمال شکست با استفاده از محاسبات آماری و فرض توزیع نرمال بر روی پارامترهای استحکامی محاسبه می گردد. برای لحاظ کردن میزان قابلیت اطمینان )یا به نوعی احتمال شکست در قطعات( می توان از میان 8 مقدار قابلیت اطمینان جدول 6-5 ]1[ استفاده نمود و ضریب قابلیت اطمینان متناظر آن را به دست آورد.
قابلیت اطمینان پرکاربرد تقریبا 99 درصد است که ضریب قابلیت اطمینان نظیر آن برابر است با:

ke = 0.814
-6 ضریب عوامل متفرقه
به دلیل در دسترس نبودن اطالعات کافی برای تعیین نوع محیط کارکرد مجموعه، پوشش فلزی به قطعه و عوامل مشابه، به ناچار ضریب عوامل متفرقه برابر 1 منظور می گردد.

kf = 1

تعیین قطر مقاطع شفت

برای تحلیل تنش های اعمالی به شفت با لحاظ کردن تنها اثرات خستگی خمشی و پیچشی، تنش های بیشینه در شفت با مقطع دایروی از روابط -6-6الف و -6 -6ب قابل محاسبه هستند.

σa = Kf

32Ma
πd

3

, σm = Kf

32Mm
πd

3

)-6-6الف(

τa = Kfs

16Ta
πd

3

, τm = Kfs

16Tm
πd

3

)-6-6ب(

از طرفی با توجه به معیار شکست انرژی واپیچش Mises Von می توان تنش های معادل دامنه و میانگین را به کمک روابط -7-6الف و -7-6ب به دست آورد.

σa

V.M. = √σa
2 + 3τa

)-7-6الف( ²

σm

V.M. = √σm
2 + 3τm

)-7-6ب( 2
همچنین با استفاده از معیار خستگی Soderberg می توان نوشت:

1
nd

=

σa

V.M.
Se

+

σm

V.M.
Sy

)8-6(

با ترکیب روابط -6-6الف تا -6 8 قطر مقاطع شفت و پس از آن ضریب اطمینان به ترتیب از معادالت -6 9 و 10-6 قابل محاسبه است:

d =
{

16nd
π

(

√4(KfMm)
2
+ 3(KfsTm)

2

Sy

+

√4(KfMa
)

2
+ 3(KfsTa

)

2

Se

)
}

1
3
)9-6(

1
nd

=

16
πd

3

(

√4(KfMm)
2
+ 3(KfsTm)

2

Sy

+

√4(KfMa
)

2
+ 3(KfsTa

)

2

Se

)

)10-6(

بدین علت که معیار استحکامی خستگی Soderberg اثرات تسلیم ماده را نیز لحاظ می کند، معیار کامل و مناسبی برای تحلیل استحکام خستگی قطعات محسوب میشود.

طراحی خارهای مستطیلی و فنری

قطعات نصب شده بر روی شفت باید تثبیت محوری شوند. قطعات منتقل کننده توان افزون بر تثبیت محوری، به تثبیت دورانی نیز احتیاج دارند. خارهای فنری و خارهای مستطیلی به ترتیب برای انجام وظایف تثبیت محوری و تثبیت دورانی در نظر گرفته خواهند شد. -1 خار مستطیلی
خارهای مستطیلی تحت دو اثر برشی و لهیدگی قرار دارند که هر دو ی این عوامل باید در تعیین طول خار دخیل شود. با تحلیل حاالت ذکرشده می توان روابط -6 -11الف و -6 -11ب را به دست آورد و با استفاده از آنها کمینه طول خار مورد نیاز را محاسبه کرد.

Ls =

4Tnd
wdSy

)-11-6الف(

Lp =

4Tnd

hdSy,min

)-11-6ب(
که در آن ها :
p طول کمینه خار از تحلیل لهیدگی | طول کمینه خار از تحلیل برش L | Ls
T گشتاور پیچشی شفت d قطر مقطع شفت در محل نصب خار w پهنای خار h ارتفاع )ضخامت( خار

nd

Sy استحکام تسلیم خار

ضریب اطمینان
کمینه استحکام تسلیم قطعات درگیر )شفت، خار و قطعه منتقل کننده توان( | min,Sy

خار و شفت هر دو از جنس 45CK بوده و دارای استحکام تسلیم 470 مگاپاسکال هستند. برای چرخدندها از جنس 4140 AISI به طور میانه می توان استحکام تسلیم 655 مگاپاسکال را برگزید . به کمک جداول استاندارد ] 6[ برای هر قطر شفت اطالعات خار مستطیلی مانند پهنا، ارتفاع و طول کمینة توصیه شده قابل دسترسی است. بنابراین می توان س ه مقدار به دستآمده برای طول خار را مقایسه نمود و بیشترین آن ها را به عنوان کمینه طول خار مورد نیاز انتخاب نمود. خارهای مستطیلی برای به کارگیری در شفت ها از جداول استاندارد ] 6[ مرجع آلمانی (DIN (و از فرم A انتخاب میگردند. الزم به توضیح است تمام فرایند انتخاب خار مستطیلی توسط برنامه رایانهای انجام می گیرد. فرمت نمایش خار مستطیلی بدین صورت خواهد بود:

retangular key DIN 6885 − A − w × h × λ

روش ایجاد جای خار مستطیلی در شفت با استفاده از فرز انگشتی در نظر گرفته می شود. طول جای خار مستطیلی با توجه به روش تراش آن مجموع طول و پهنای خار خواهد بود. در مواردی که کمینه طول جاخار مستطیلی نسبتاً نزدیک به پهنای قطعه منتقل کننده توان و بزرگتر از آن شود، سبب تداخل میان جای خار مستطیلی با جای خار فنری و پله شفت خواهد شد. این تداخل منجر به تجمیع اثرات تمرکز تنش میشود که خستگی شفت را تشدید می کند. برای پرهیز از این پدیده ناچاراً می بایست پهنای قطعه را به طور موضعی افزایش داد و در واقع میان نقاط تمرکز تنش فاصله انداخت. بدین منظور می توان از نافی یا spacer استفاده نمود. با تعیین ق طر مقاطع شفت، میتوان خارهای شفت را طراحی نمود. با محاسبه خار و جای خار مستطیلی، دو نامزد بحرانی دیگر که در مرحله پیشین غیرقابل تعیین بودند ، بر روی شفت پدیدار میشوند. این دو نقطه، نقاط ابتدایی و انتهایی جای خار مستطیلی به سمت میانه شفت هستند که برای افزای ش اطمینان در طراحی شفت، این دو نقطه نیز به عنوان نقاط بحرانی مد نظر قرار می گیرند. -2 خار فنری
همه قطعاتی که روی شفت سوار می شوند نیاز به تثبیت محوری دارند. در حالت معمول قطعات روی شفت از یک سمت توسط پله و از سمت دیگر با استفاده از خار فنری در طول شفت مهار می گردند. تعیین خار فنری رابطه خاصی ندارد و برخالف خار مستطیلی تحت بارگذاری نیست بلکه از طریق جداول استاندارد ] 6[ برمبنای قطر محل قرارگیری خارفنری انتخاب می شود. باید دقت شود خار فنری در دو دسته داخلی و خارجی و همینطور هر کدام در دو نوع معمولی و سنگین در دسترس قرار دارند. خار فنری بر روی شفت از نوع خارجی تحت عنوان خار فنری محور و برای سادگی کار در کاربرد جعبه دنده ساده از نوع معمولی آن استفاده می شود. بنابراین همانند خارهای مستطیلی، خارهای فنری نیز از مرجع آلمانی انتخاب گردیده و بدین شکل نمایش داده می شوند:

external normal retaining ring DIN 471 − d × s
که در آن d قطر محل قرارگیری روی شفت و s پهنای خار فنری است.

طرح اولیه شفت ها و فواصل میان قطعات طرح اولیه هر یک از سه شفت به همراه نماد ابعاد طولی محل اعمال نیرو در شکل های -6 8 تا -6 10 نمایش داده شده است. فاصله محل اعمال نیرو از سمت چپ شفت به عالوه طول نهایی شفت در قالب یک بردار پنجمولفه ای تحت عنوان »طولهای تخمینی« ثبت شده و برای محاسبات مربوط به شفت مورد استفاده قرار می گیرد.

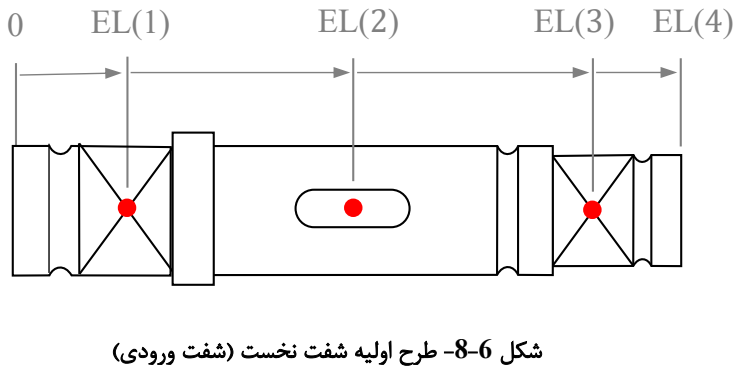
[picture p15: figure]

شکل -6 -8 طرح اولیه شفت نخست )شفت ورودی(

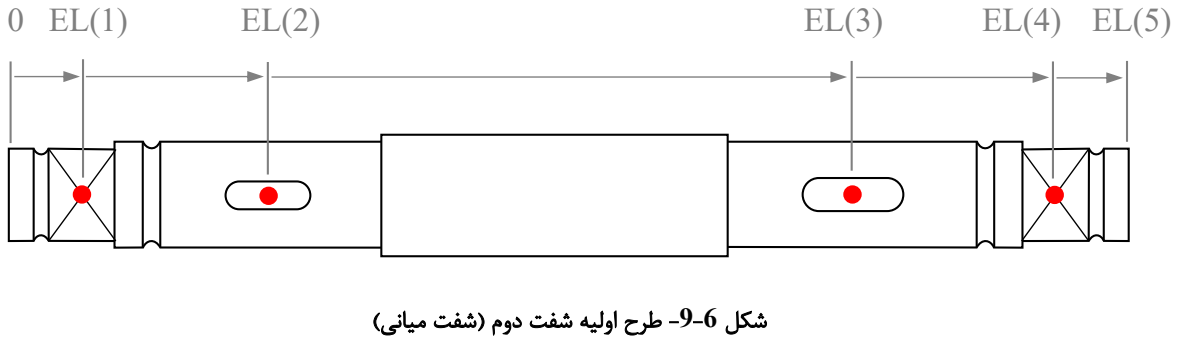
[picture p16: figure]
شکل -6 -9 طرح اولیه شفت دوم )شفت میانی(
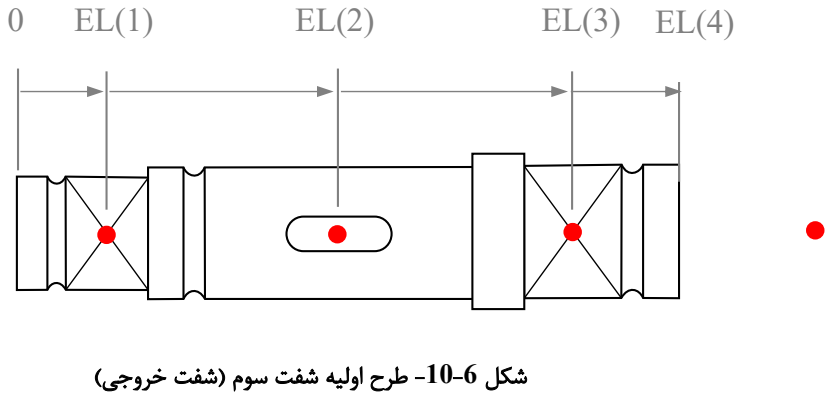
[picture p17: figure]

شکل -6 -10 طرح اولیه شفت سوم )شفت خروجی (

افزون بر بردار طول های تخمینی، یک ماتریس ده در شش حاوی مشخصات نقاط ده گانه )نقاط تمرکز تنش اولیه( تدوین می گردد. این ماتریس به عنوان ماتریس فواصل شفت نامگذاری شده و شش ستون آن که هر یک حامل مشخصات نقاط ده گانه است، اطالعات زیر را دربردارد: 1( ستون اول : شماره نقاط ده گانه به ترتیب از چپ به راست 2( ستون دوم : راهنمای نوع تمرکز تنش از میان سه نوع تمرکز تنش یادشده
- عدد 1 نشانگر تمرکز تنش پله
- عدد 2 نشانگر تمرکز تنش جاخار فنری
- عدد 3 نشانگر تمرکز تنش جاخار مستطیلی 3( ستون سوم : فاصله هر نقطه از سمت چپ شفت )مبدأ(

4( ستون چهارم: راهنمای وجود یا عدم وجود گشتاور پیچشی در آن نقطه
- عدد 1 به معنای وجود گشتاور پیچشی
- عدد 0 به معنای نبود گشتاور پیچشی 5( ستون پنجم : پهنای قطعه منتقل کننده توان
- تنها برای نقاط تمرکز تنش جاخار مستطیلی وجود دارد و برای سایر نقاط برابر صفر است. 6( ستون ششم : تنش تسلیم قطعه منتقل کننده توان
- تنها برای نقاط تمرکز تنش جاخار مستطیلی وجود دارد و برای سایر نقاط برابر صفر است.

شرح تابع تعیین قطر مقاطع شفت تابع تعیین قطر مقاطع شفت در قالب یک کد با نام ShaftDiameters تدوین شدهاست. این تابع ورودی هایی را دریافت نموده و با کمترین تعامل میان کاربر، روند محاسبات و تکرارهای مورد نیاز این فاز را طی کرده و در نهایت نتیجه فرایند طراحی را به صورت خروجی هایی در اختیار فاز آخر پروژه قرار می دهد.

ورودی های تابع قطرهای شفت از این قرار هستند:
- راهنمای ابعادی شفت در قالب یک ماتریس ده در شش
- بردار توزیع گشتاور خمشی در شفت
- گشتاور پیچشی شفت
- چینش ابعادی شفت به صورت بردار پنج مولفه ای
- ضریب اطمینان مجموعه
- بردار حامل اسامی قطعات سوارشده بر روی شفت پیش از شروع فرایند سعی وخطا برای تعیین قطر مقاطع شفت توزیع گشتاور پیچشی میان نقاط ده گانه شفت اختصاص می یابد و به دنبال آن گشتاور پیچشی دامنه و میانه محاسبه می شود. سپس برای به دست آوردن تنش حد دوام، ضرایب Marin با توجه به شرایط کاری محاسبه شده و تنها ضریب اندازه نیاز به معین بودن قطر شفت دارد لذا با در نظر گرفتن نقطه پنجم شفت و به کمک یه قطر حدسی، با همگرایی کمتر از یک درصد، حد دوام تخمینی محاسبه خواهد شد. در مرحله بعد ضرایب تمرکز تنش در سه دسته مجزا به صورت تخمینی و محتاطانه مقداردهی می شوند و درنهایت مسیر برنامه وارد حلقه تکرار اساسی می گردد. در این حلقه برای هر یک از نقاط ده گانه که مستعد تمرکز تنش هستند، با استفاده از ضرایب تمرکز تنش و توزیع های گشتاور خمشی و پیچشی، کمینه قطر هر مقطع محاسبه می شود. الزم به توضیح است محل وجود جای خارهای مستطیلی و فنری به طور جداگانه ثبت می شود تا در تعیین خار از آنها استفاده گردد.

همچنین نقطه تحت اثر بیشینه گشتاور خمشی در طول شفت نیز، نقطه بحرانی محسوب می گردد بنابراین در صورتی که این نقطه یکی از نقاط ده گانه باشد، صرف نظر می شود و درغیر این صورت این نقطه، یاتاقان نشین است و باید بررسی گردد. در نهایت قطر این نقاط ده گانه به همراه نقطه بیشینه خمش )درصورت متفاوت بودن( به صورت ردیفی در یک جدول به همراه نشانگر نوع تمرکز تنش و نام قطعه سوارشده، به کاربر نمایش داده می شود تا وی در قالب یک بردار ده مولفه ای قطرهای مقاطع را تصحیح کند. پس از تصحیح این قطرها، برنامه یک نسخه کپی از این مقادیر تهیه نموده تا با کمک آن بتواند همگرایی فرایند تکرار را تشخیص دهد و برنامه را از تکرار خارج کند.

در ادامه قطرهای تصحیحی به بخش تعیین خارها منتقل می شوند تا خار مناسب مستطیلی برای تثبیت دورانی و خار فنری برای تثبیت محوری قطعات انتخاب شود. در این قسمت با کمک دو متغیری که محل این دو نوع خار در آن ها ثبت گردید و بردار قطرهای تصحیح شده، قطر شفت در محل وقوع خار مستطیلی را از میان قطرهای انتخاب نموده و به صورت تمام خودکار پهنا، ارتفاع و کمترین طول مجاز )توصیه شده( را از جداول استاندارد ] 6[ استخراج می کند. سپس با کمک این اطالعات، طول خار ناشی از برش و لهیدگی خار با طول کمینه مجاز مقایسه گردیده و بیشینه آنان به عنوان طول خار اعالم می شود. هم چنین با استفاده از پهنای خار امکان تعیین طول جای خار وجود دارد. این طول جای خار مستطیلی با پهنای قطعه مذکور مقایسه گردیده و درصورت بزرگتر بودن، قطعه نیاز به نافی می یابد و لذا برنامه پیغامی بر همین مبنا به کاربر نمایش می دهد که در صورت وجود جای کافی برای نصب نافی، مشکلی ایجاد نخواهد شد اما در غیر این صورت می بایست در چینش ابعادی شفت تجدید نظر شود. با تعیین طول جای خار مستطیلی، دو نامزد دیگر برای بحرانی بودن شفت )که پیش از آن قابل تعیین و میزان بحرانی بودن آنان مبهم بود( ق ابل محاسبه می گردند؛ این دو نقطه، نقاط ابتدایی و انتهایی جای خار مستطیلی به سمت میانه شفت هستند. این دو نقطه مجدداً به ابتدای حلقه ارسال نمی گردند و تنها قطر حاصل از آنان با قطر محل نشیمنگاه قطعه مقایسه می شود که در صورت ایمن بودن روند طراحی ادامه یافته و در صورت بحرانی بودن، کاربر با پیغام هشدار مواجه خواهد شد. با ادامه روند، سه پارامتر خار مستطیلی، به عنوان داده های جدید در راهنمای ابعادی شفت ذخیره می گردند تا در مدلسازی و تهیه نقشه ها از آنان استفاده شود.

پس تعیین ابعاد خار و جای خار مستطیلی، نوبت به محاسبات خار فنری می رسد. در این قسمت نیز بر اساس پارامتری که محل نقاط خار فنری را در خود ذخیره کرده است، برنامه قادر خواهد بود از میان بردار قطرهای تصحیحی، قطر محل خار فنری را بیرون بکشد و به کمک آن پهنای جای خار فنری، حداقل فاصله از لبه پله و قطر داخلی جای خار فنری را از جداول استاندارد استخراج نماید. این ابعاد در صورت تایید یعنی مهیا بودن حداقل شرایط الزم برای تراش خار فنری در محل معلوم، در کنار مشخصات خار مستطیلی، درون راهنمای ابعادی شفت، تجمیع می گردند. بعد از یک مرحله اجرای حلقه، قطرهای تصحیح شده به ه مراه ابعاد جای خارها به ابتدای حلقه ارسال گردیده و این بار با استفاده از آن ها، ضرایب تمرکز تنش اصالح و به روز می شوند و مجدداً به مسیر تکرار حلقه تزریق خواهند شد. همانگونه که بدان اشاره گردید، با همگرایی روند تصحیح قطرها، حلقه تکرار خاتمه می یابد.

در پایان روند طراحی این قسمت، نهایتا ضریب اطمینان در حداقل دوازده نقطه بحرانی محاسبه گردیده و در معرض نمایش کاربر قرار می گیرد که در صورت رعایت حداقل ضریب اطمینان ، روند طراحی با موفقیت خاتمه می یابد و درغیراین صورت نقطه یا نقاطی که از لحاظ ضریب ایمنی کمتر از حد مجاز هستند به همراه پیغامی برای بازطراحی یا بازنگری طرح نمایش داده می شود. برنامه برای خروج از حلقه تکرار، قطر نقاط ده گانه را یکتا نموده و قطر پله میانی شفت را نیز بدان اضافه می کند. در واقع خروجی نهایی تنها شامل قطر پنج مقطع شفت خواهد بود که در قالب یک بردار پنج مولفه ای به فاز انتخاب یاتاقان ارسال میگردد.

نتیجه نهایی فاز چهارم برای طراحی زیرسامانه زنجیر-چرخ زنجیر در جدول 1-6 ثبت شدهاست.

جدول -1-6 ابعاد طولی شفت ها
فاصله نقاط از سمت چپ شفت )میلی متر( | نقاط هشت گانه
| | شفت نخست شفت دوم شفت سوم
10 | 10 | 10 | 1
30 | 30 | 20 | 2
40 | 40 | 40 | 3
60 | 52 | 50 | 4
80 | 64 | 65 | 5
90 | 124 | 80 | 6
110 | 148 | 90 | 7
120 | 172 | 110 | 8
| | | طول شفت 120 180 130

فصل پنجم: فاز سوم پروژه انتخاب یاتاقانها

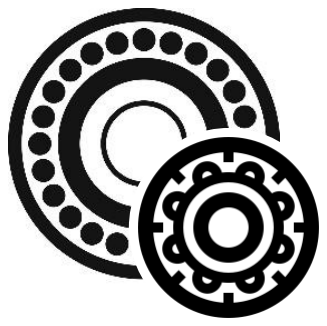
[picture p18: figure]

-5

## فصل پنجم فاز سوم پروژه

فصل پنجم: فاز سوم پروژه انتخاب یاتاقانها

### فاز س وم پروژه )طراحی یاتاقان های جعبه دنده (

یاتاقانهای مجموعه وظیفه مهارکردن شفت های جعبه دنده و تحمل نیروهای تکیه گاهی را بر عهده دارند. یاتاقانها نیروهای تکیه گاهی را در نهایت به شاسی نشیمنگاه جعبه دنده منتقل می کنند. با توجه به این که در فاز چهارم پروژه قطر مقاطع مختلف شفت و از جمله قطر محل نشیمن یاتاقان ها تعیین شده است، طراحی یاتاقانها از همین قطرها شروع می شود. پیش از شروع طراحی یاتاقان ها الزم است تا یاتاقانی که بار محوری را تحمل می کند، مشخص گردد. در این مرحله سعی می شود یاتاقانی که بار شعاعی کمتری دارد، بار محوری بر آن تحمیل شود مگر اینکه اختالف قطر یاتاقان ها زیاد بوده و بار محوری، اختالف قابل مالحظه ای میان قطر یاتاقان و قطر محل نشیمنگاه آن ایجاد کند. در این صورت منطقی است که بار محوری توسط یاتاقان بزرگتر تحمل شود. یاتاقانی می تواند بار محوری را تحمل کند که در جهت محوری کامالً به پوسته مقید شده باشد. البته تقید به پوسته شرط کافی نیست. بر تمامی یاتاقانها نمیتوان بار محوری تحمیل نمود. در یک دسته بندی عمده، تنها یاتاقانهای غلتشی کروی مستعد حمل بار محوری هستند و یاتاقان های غلتشی استوانه ای از تحمل بار محوری سر باز می زنند.
برای شروع کار، تمام یاتاقان ها از نوع شیارعمیق انتخاب میشوند. در صورتی که مجموعه شش یاتاقانی نتواند قابلیت اطمینان کل مورد نیاز کارفرما را برآورده کند، انتخاب بعدی می تواند یاتاقان غلتک استوانه ای باشد. یاتاقانهای غلتکی با این که بار محوری تحمل نمی کنند )یا بسیار ناچیز تحمل میکنند ( اما نسبت به یاتاقان ساچمهای معادل خود به علت این که سطح تماس بیشتری ایجاد می کنند، توانایی بهتری در تحمل بار شعاعی دارند. بنابراین در صورت نیاز استفاده از یاتاقانهای غلتک استوانه ای انتخاب مناسبی برای یاتاقان فاقد بار محوری خواهد بود.
با این تفاسیر در هر شفت حداقل یک یاتاقان شیارعمیق )بنابر درخواست کارفرما( به کار برده می شود و یاتاقان دوم می تواند شیارعمیق یا غلتکاستوانه ای انتخاب گردد. شکل متداول هر کدام از یاتاقانهای نام برده در مجموعه استفاده خواهد شد تا دشواری تهیه آن ها در بازار کشور کاهش یابد. بنابراین یاتاقانهای شیارعمیق از سری 02 و یاتاقان های غلتکاستوانه ای از نوع NU سری 2 انتخاب می گردند. هم چنین مرجع گزینش یاتاقانها از کاتالوگ SKF[ 4 ]بوده و نحوه نامگذاری هر یک از یاتاقانهای مورد استفاده بدین صورت خواهد بود:

deep groove ball bearing seri 02: 62**

cylindrical roller bearing: NU 2** ECP

فصل پنجم: فاز سوم پروژه انتخاب یاتاقانها

شرح تابع انتخاب یاتاقان
تابع انتخاب مجموعه یاتاقانها در قالب یک کد با نام BearingSelection تدوین شدهاست. این تابع ورودی هایی را دریافت نموده و با کمترین تعامل میان کاربر، روند محاسبات و تکرارهای مورد نیاز این فاز را طی کرده، نتیجه را به وی نمایش داده و پس از تایید او نهایتاً اصل و پایه طراحی جعبه دنده به پایان می رسد .

ورودی های تابع انتخاب یاتاقان بدین شرح هستند:
- مجموعه سرعت دورانی های هر سه شفت در قالب یک بردار افقی سه مولفه ای
- نیروهای تکیه گاهی در محل هر یاتاقان بر روی هر سه شفت در قالب یک ماتریس سه در دو
- قطر محل نشیمن گاه هر یاتاقان بر روی هر سه شفت در قالب یک ماتریس سه در دو
- راهنمای تعیین نیروی محوری بر روی یک یاتاقان از هر سه شفت در قالب یک ماتریس سه در دو
- نیروی محوری هر سه شفت در قالب یک بردار افقی سه مولفه ای پیش از شروع فرایند سعی و خطا ابتدا از کاربر درخواست می شود تا قابلیت اطمینان مجموعه یاتاقانهای جعبه دنده را وارد نماید. پس از آن در طی یک مرحله حلقه تکرار روند انتخاب یاتاقان های مناسب انجام خواهد شد.
روند طراحی بدین صورت است که از شفت اول تا شفت سوم به ترتیب هر کدام از یاتاقانها برمبنای قطر تعیینشده در محل نشیمن گاه انتخاب گردیده و میزان قابلیت اطمینان هر کدام در یک ماتریس سه در دو ثبت می گردد. اطالعات الزم یاتاقانهای مورد نیاز در این جعبه دنده از قطر 15 تا 50 میلی متر مانند ظرفیت بار دینامیکی، بار استاتیکی، ضریب کاتالوگ SKF( تنها برای یاتاقانهای شیارعمیق( و پهنای آنان در قالب جدولی در خارج برنامه ذخیره شده و توس ط برنامه در داخل آن مورد استفاده قرار می گیرد. همینطور جدول مبنای انتخاب یاتاقان شیارعمیق )جدول 8 صفحه 315 کاتالوگ SKF )در حین اجرای برنامه بارگیری شده و تعیین بار معادل شعاعی برای یاتاقانهای حامل بار محوری به صورت خودکار انجام خواهد شد. مبنای تشخیص یاتاقان حامل بار محوری، ماتریس راهنمای دودویی است. پس تکمیل فرایند انتخاب یاتاقانهای شیارعمیق در هر شش جایگاه، قابلیت اطمینان کل مجموعه با قابلیت اطمینان اعالم شده توسط کارفرما مقایسه می گردد که در صورت تایید شرایط، فرایند انتخاب یاتاقان ها تماماً براساس یاتاقانهای شیارعمیق به اتمام می رسد و درغیر این صورت برنامه پیشنهاد استفاده از یاتاقان های غلتک استوانه ای را به کاربر میدهد. در صورت موافقت کاربر برای استفاده از یاتاقان های غلتکاستوانهای، خط جریان محاسبات تعویض می شود. بدین ترتیب که جدول انتخاب یاتاقان های غلتک استوانهای وارد مسیر محاسبات می گردد و پارامتر a نیز برای یاتاقانهای استوانه تغییر می کند. در غیر این صورت چاره ای جز اصالح قطرها پیشروی کاربر وجود ندارد.

فصل پنجم: فاز سوم پروژه انتخاب یاتاقانها

در صورت استفاده از یاتاقانهای غلتک استوانه ای، کاربر می بایست آن دسته از یاتاقانهایی را که قصد جایگزینی دارد طبق قابلیتهای اطمینان و راهنمای ظاهر شده با عدد 1 و سایر یاتاقان ها را با عدد 0 مشخص کند. با وارد کردن این اطالعات مسیر برنامه به ابتدای حلقه تکرار می رسد که این بار تنها یاتاقان های مشخصشده و فاقد بار محوری تحلیل می گردند. در صورت برقراری شرط حداقل قابلیت اطمینان مجموعه فرایند تکرار پایان یافته و ترکیبی از یاتاقانها برای جعبه دنده انتخاب می شود. طی چند مرحله آزمایش در هر سه جایگاه مستعد نصب یاتاقان غلتک استوانهای و برآ ورده نشدن مجدد خواسته کارفرما، برنامه با خواست خود کاربر خاتمه یافته و چاره ای جز تغییر در قطرهای مقاطع و بازبینی مجدد طرح وجود نخواهد داشت.
با انتخاب یاتاقانها، برمبنای پهنای هر یاتاقان، طول شفت و ابعاد آن اصالح شده و مراحل طراحی شفت تکرار می شود و پس از آن یاتاقان های انتخابی مجدداً چک می گردند .

خروجی های تابع انتخاب یاتاقان به شرح زیر هستند:
- نوع یاتاقان انتخابی در هر شش جایگاه در قالب یک ماتریس رشته ای سه در دو
- قابلیت اطمینان هر یاتاقان در قالب یک ماتریس سه در دو نتیجه نهایی فاز پنجم برای انتخاب یاتاقان ها در شکل -7 1 نمایش داده شده است.

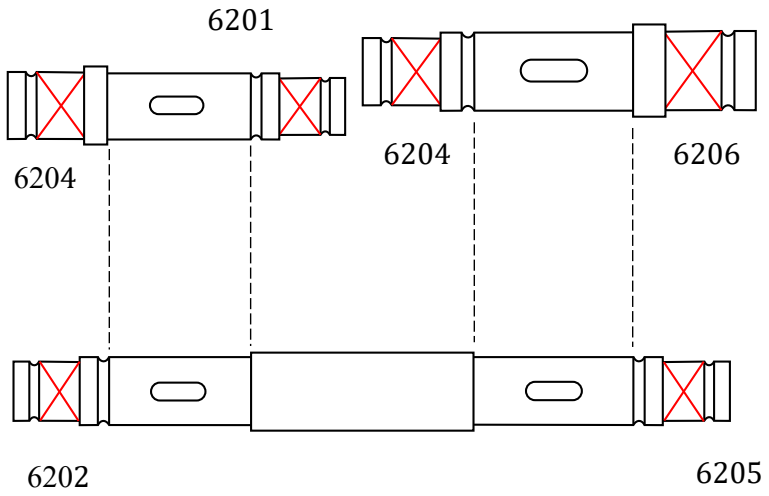
[picture p19: figure]

شکل -7 -1 مشخصات نهایی یاتاقان های مجموعه

فصل ششم خروجی نقشه ها

## -6 فصل ششم خروجی نقشه ها

فصل ششم خروجی نقشه ها

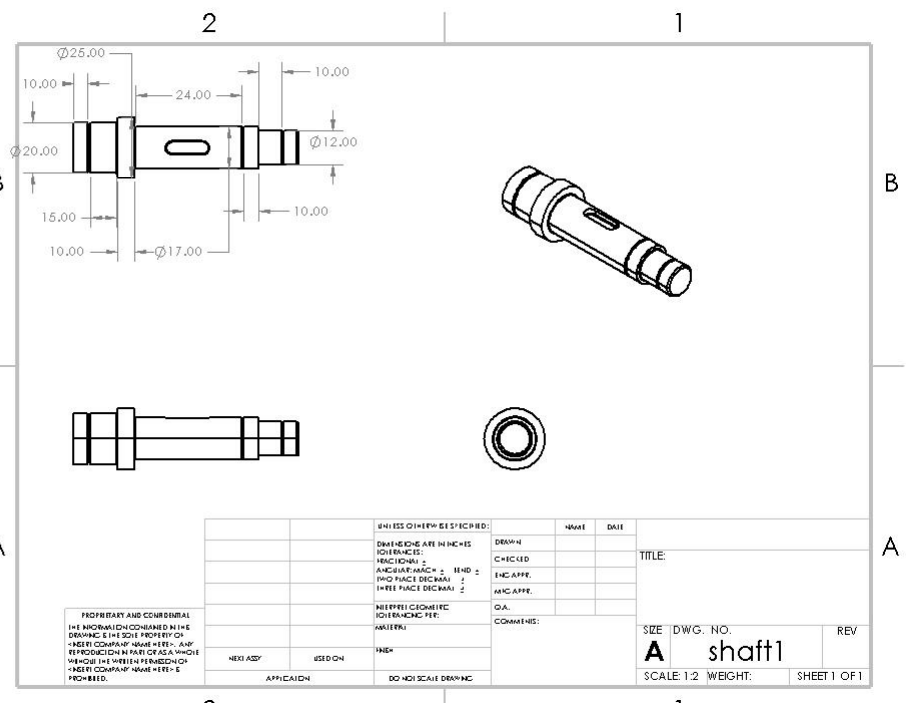
[picture p20: figure]

فصل ششم خروجی نقشه ها

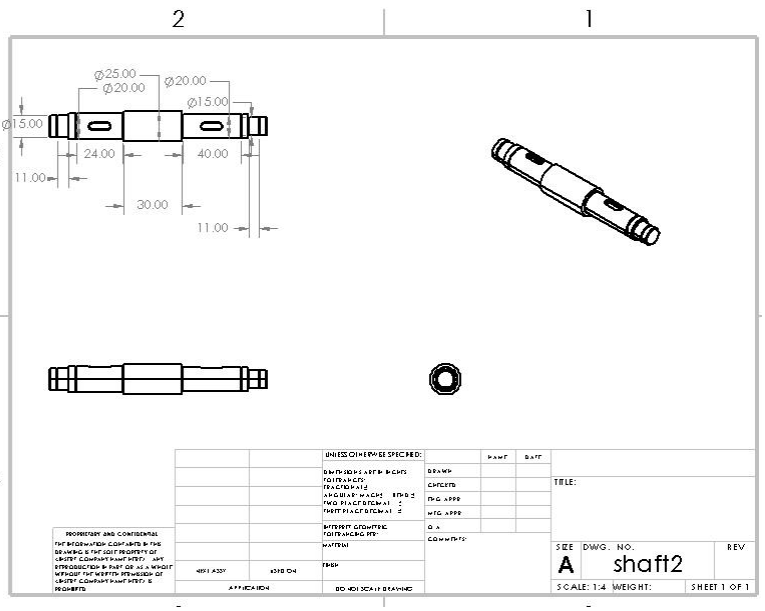
[picture p21: figure]

فصل ششم خروجی نقشه ها

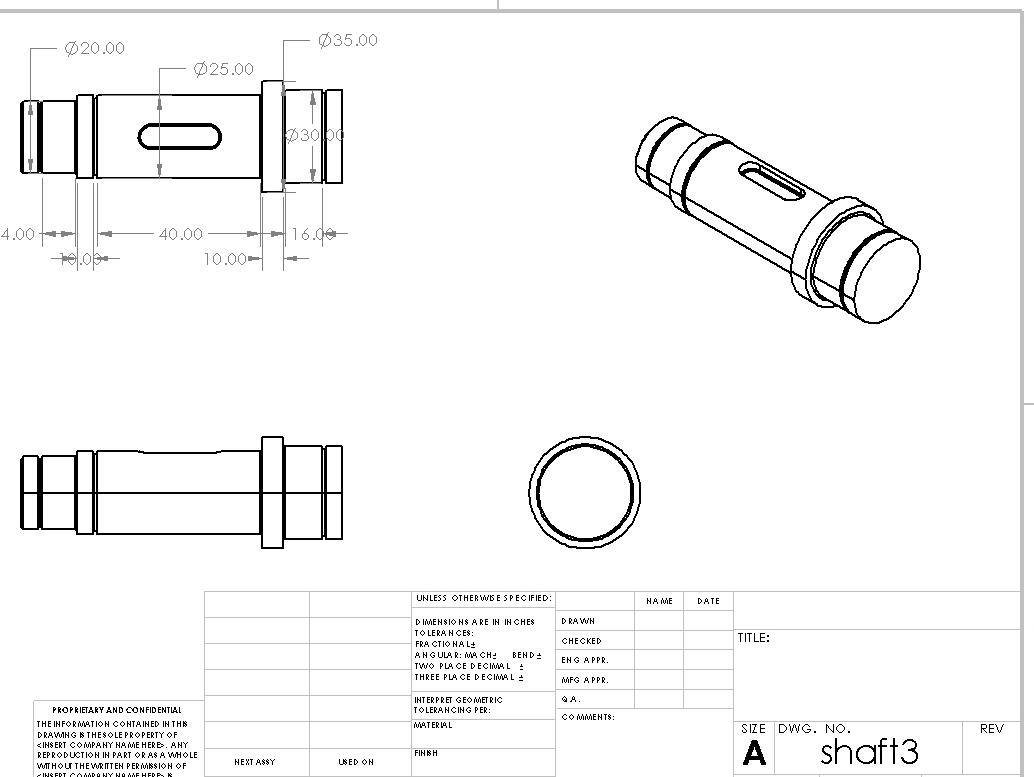
[picture p22: figure]
