farzamjahani/MachineDesign/shaft1.JPG

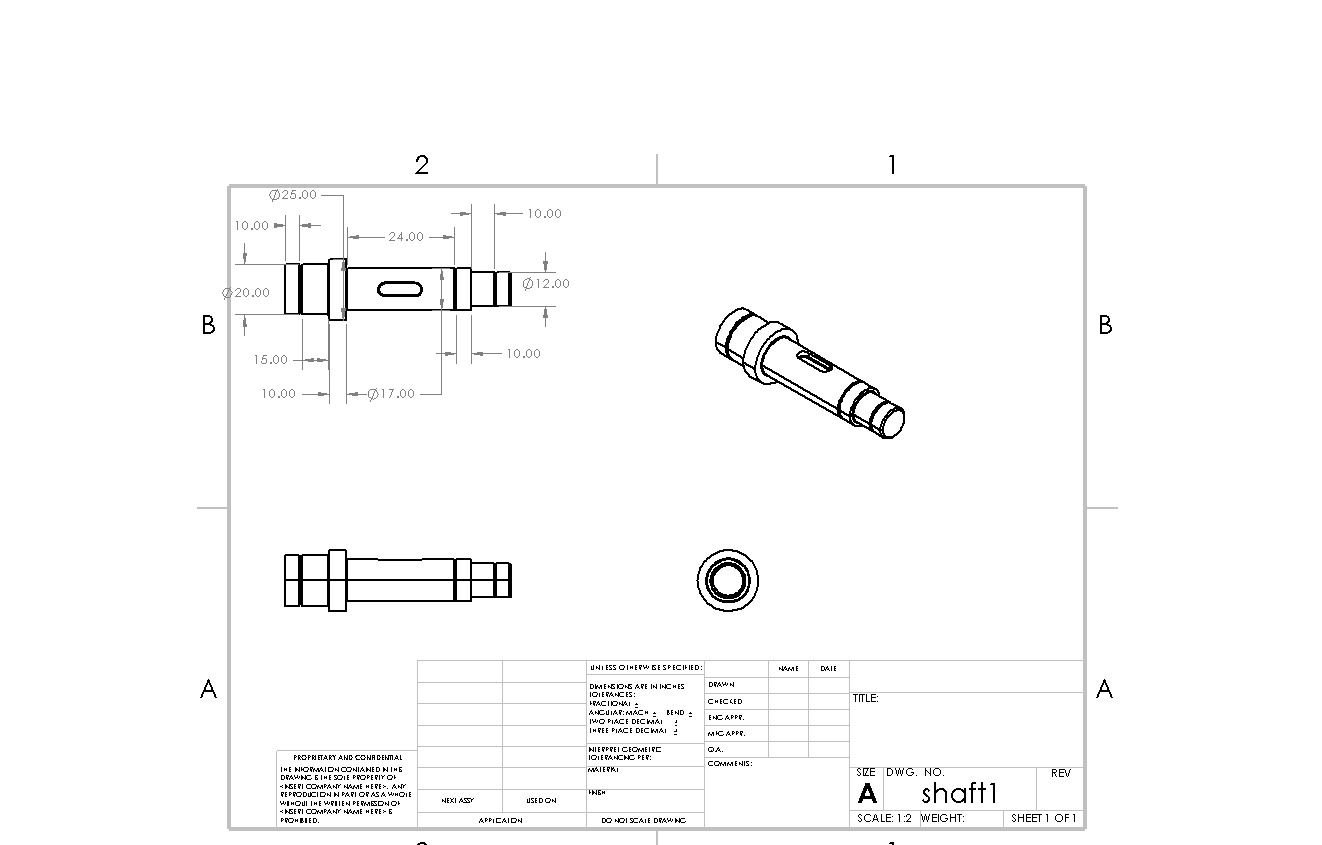
shaft1.JPG
