farzamjahani/MachineDesign/shaft2.JPG

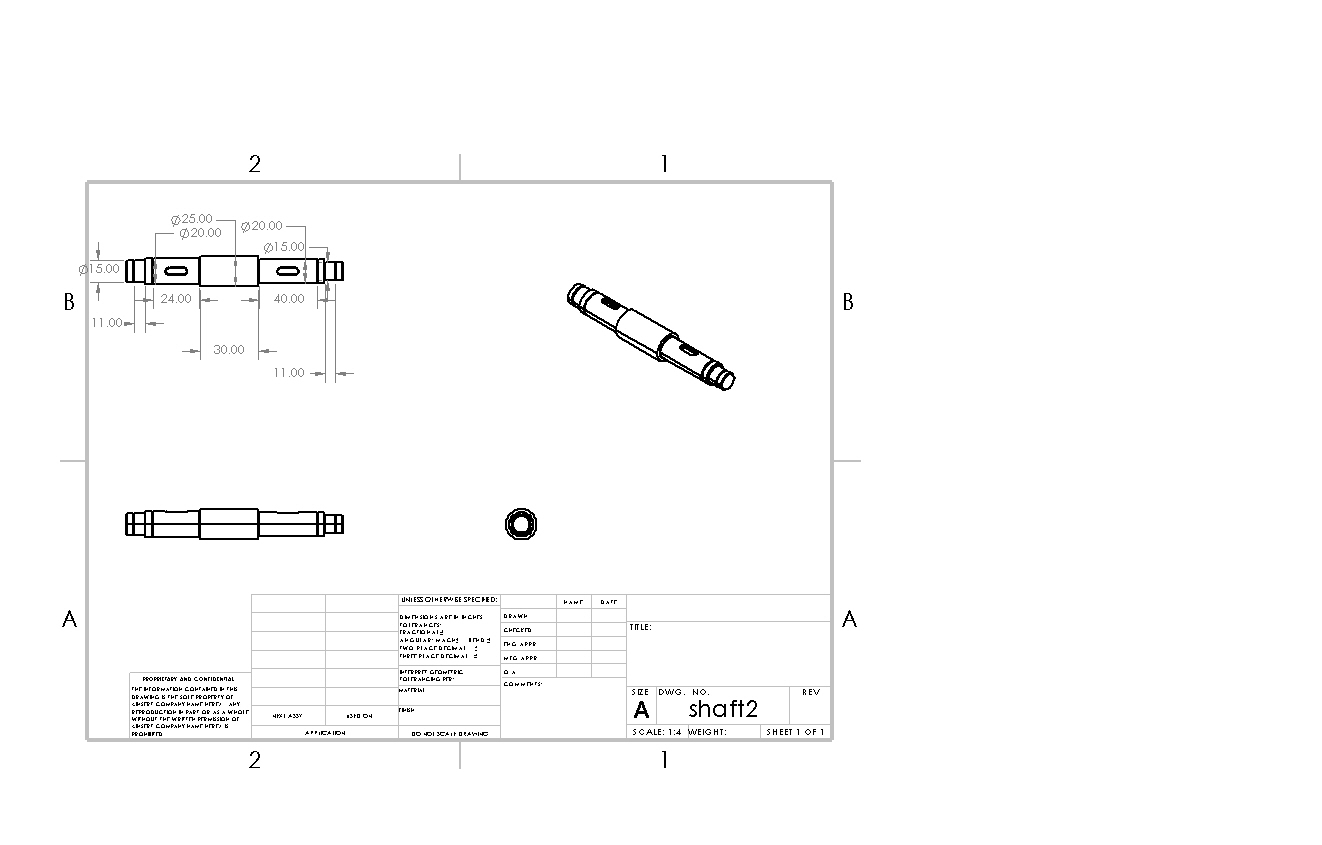
shaft2.JPG
