farzamjahani/MachineDesign/shaft3.JPG

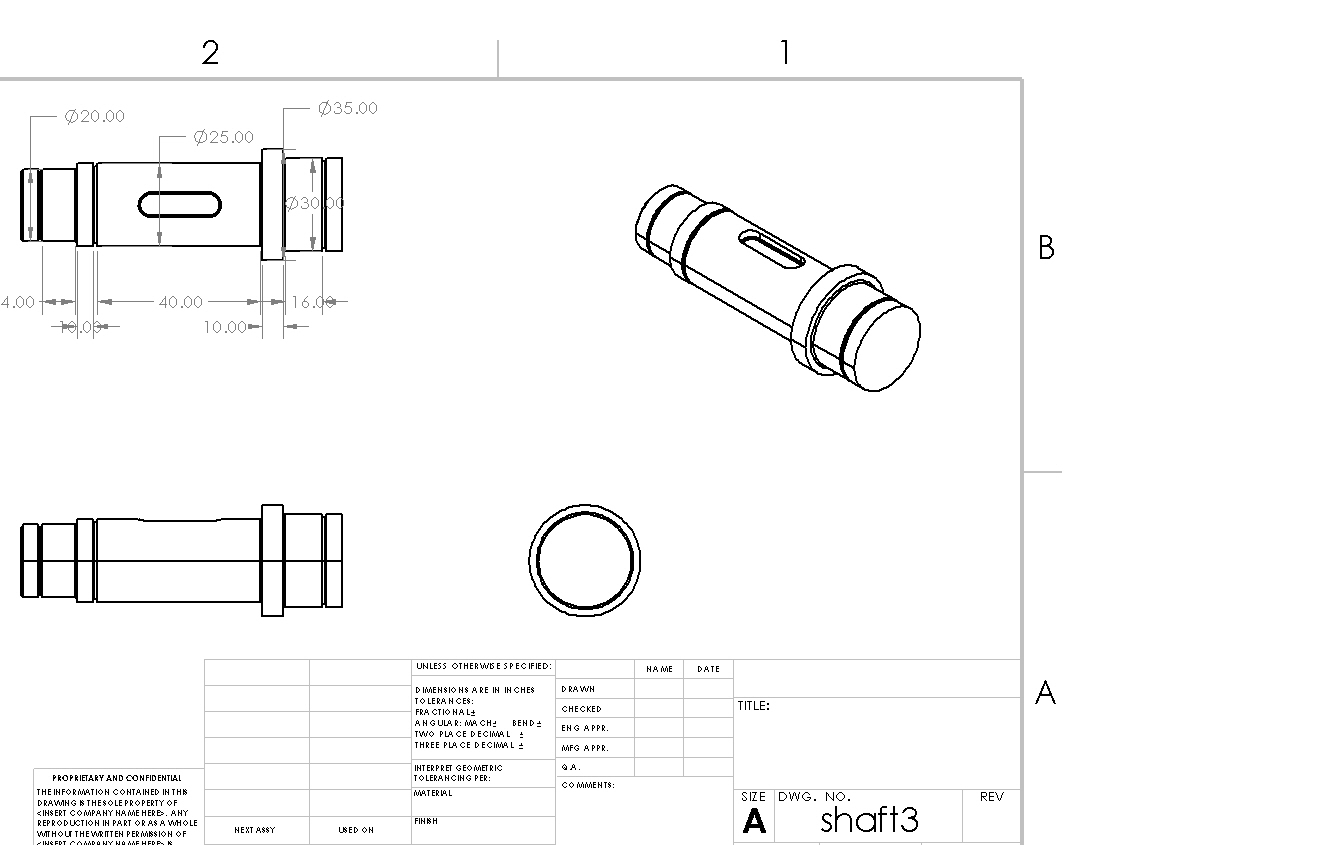
shaft3.JPG
