farzamjahani/MachineDesign/solid files/Input Shaft Cover Gasket.STEP

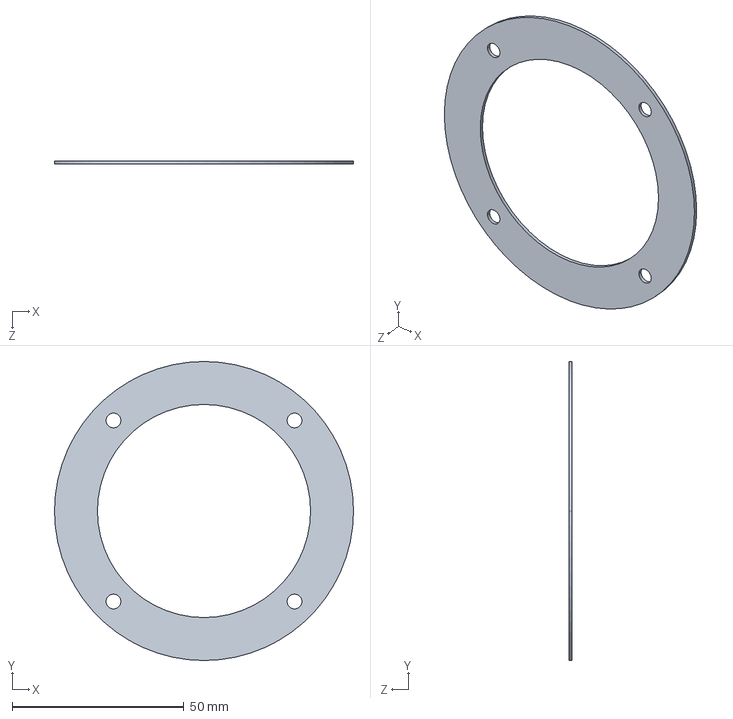
[picture p26: CAD file, 2024-09-07]
solid files/Input Shaft Cover Gasket.STEP
87.0 x 87.0 x 1.00 mm
