farzamjahani/MachineDesign/solid files/Oil Cap.STEP

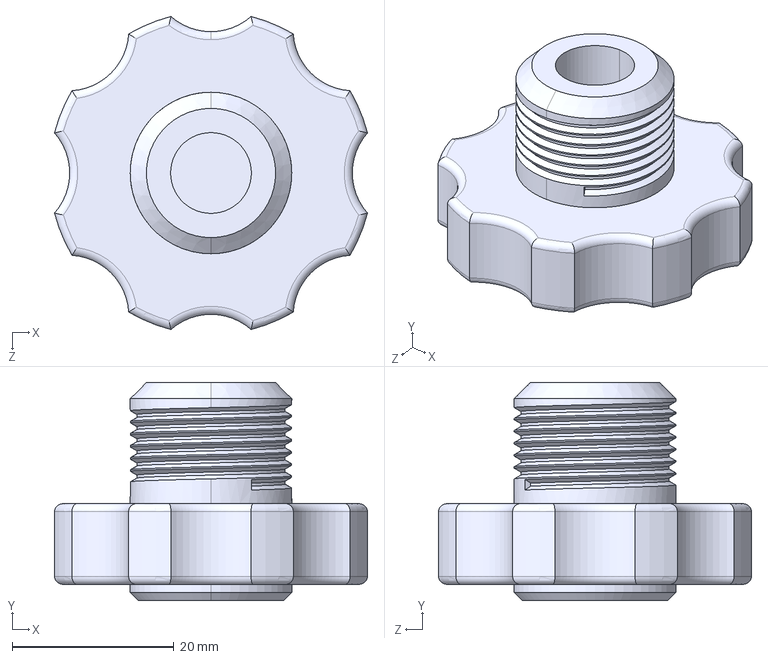
[picture p27: CAD file, 2024-09-07]
solid files/Oil Cap.STEP
38.8 x 27.0 x 38.8 mm
