farzamjahani/MachineDesign/solid files/Upper Casing.STEP

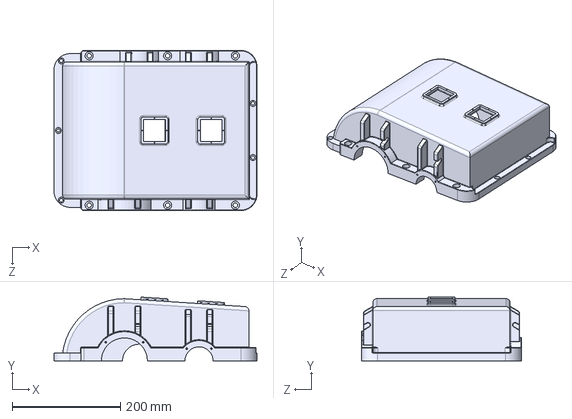
[picture p28: CAD file, 2024-09-07]
solid files/Upper Casing.STEP
375.0 x 118.0 x 296.0 mm
