farzamjahani/MachineDesign/solid files/shaft3.SLDPRT

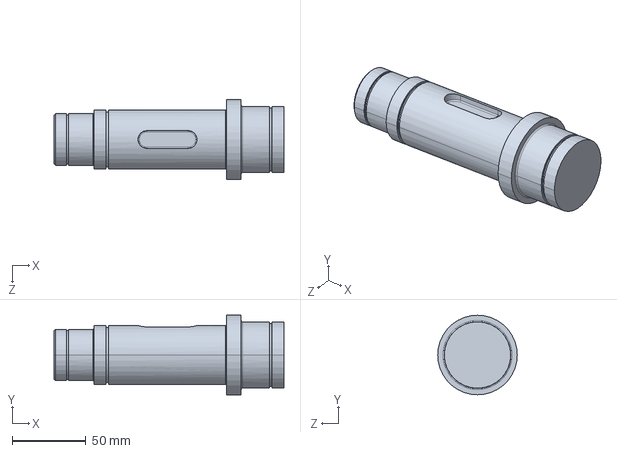
[picture p29: CAD file, 2024-09-07]
solid files/shaft3.SLDPRT
156.0 x 54.0 x 54.0 mm
