farzamjahani/MachineDesign/solid files/Window Seat.STEP

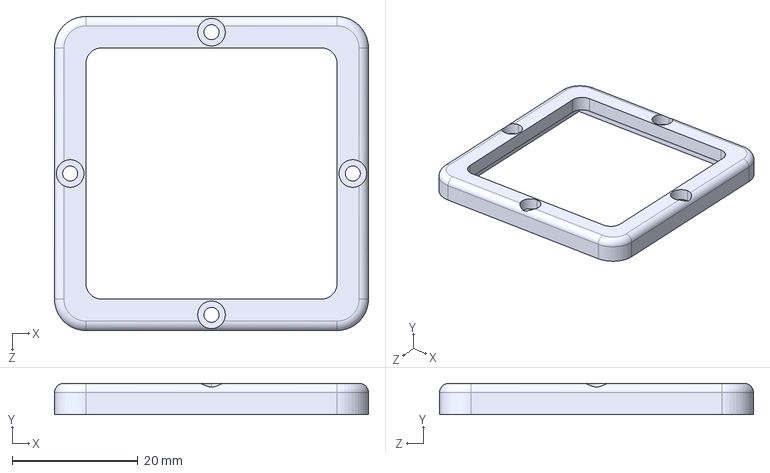
[picture p30: CAD file, 2024-09-07]
solid files/Window Seat.STEP
50.0 x 5.00 x 50.0 mm
