farzamjahani/MachineDesign/solid files/radial ball bearing_68_skf.STEP

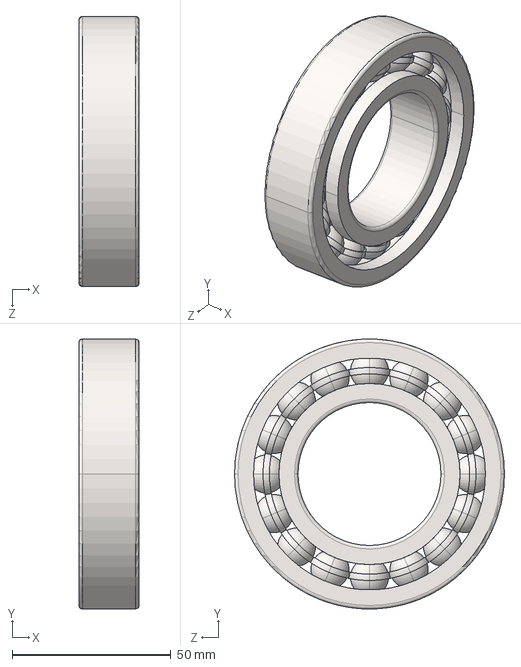
[picture p31: CAD file, 2024-09-07]
solid files/radial ball bearing_68_skf.STEP
19.0 x 85.0 x 85.0 mm
