farzamjahani/MachineDesign/solid files/Parallel key A8 x 7 x 26 DIN 6885.STEP

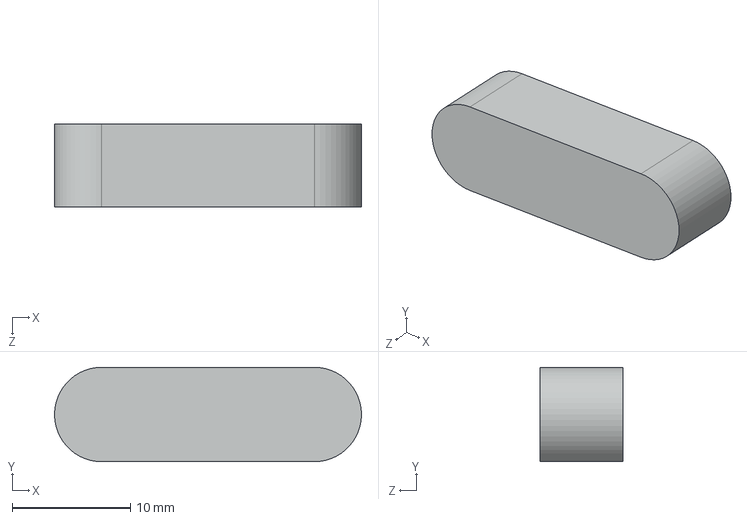
[picture p32: CAD file, 2024-09-07]
solid files/Parallel key A8 x 7 x 26 DIN 6885.STEP
26.0 x 8.00 x 7.00 mm
