farzamjahani/MachineDesign/solid files/circlip for shafts normal_din.STEP

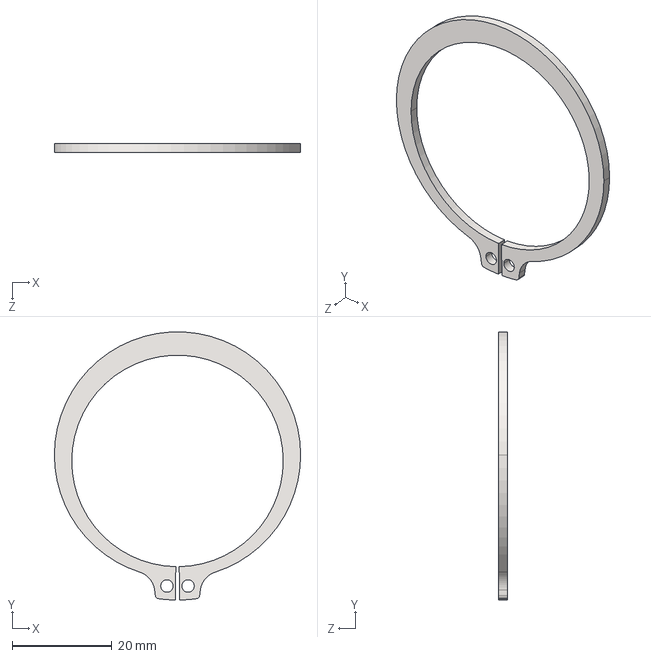
[picture p33: CAD file, 2024-09-07]
solid files/circlip for shafts normal_din.STEP
49.5 x 53.9 x 1.75 mm
