farzamjahani/MachineDesign/solid files/Intermediate Shaft Cover Gasket.STEP

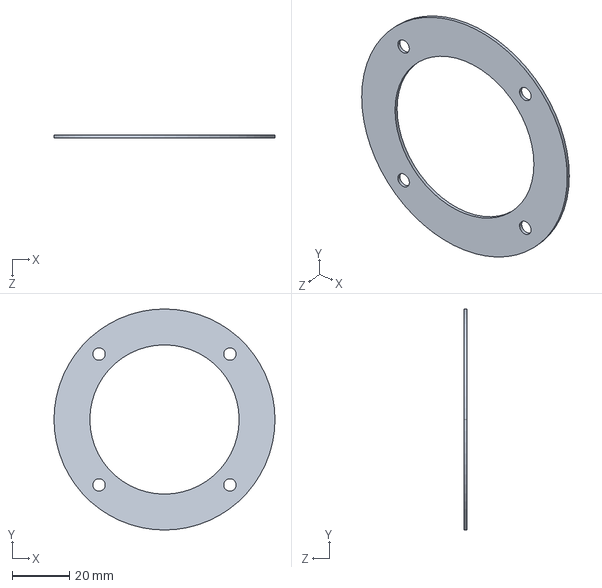
[picture p34: CAD file, 2024-09-07]
solid files/Intermediate Shaft Cover Gasket.STEP
77.0 x 77.0 x 1.00 mm
