farzamjahani/MachineDesign/solid files/Shaft Holder_1.STEP

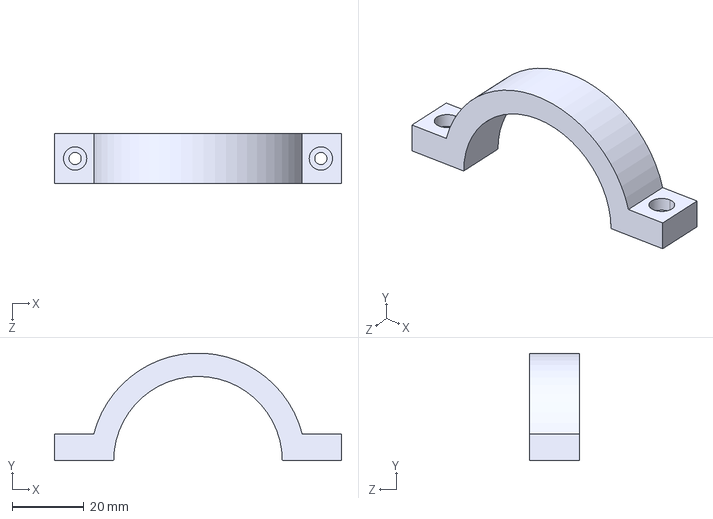
[picture p35: CAD file, 2024-09-07]
solid files/Shaft Holder_1.STEP
80.0 x 30.0 x 14.0 mm
