farzamjahani/MachineDesign/solid files/Shaft Holder.STEP

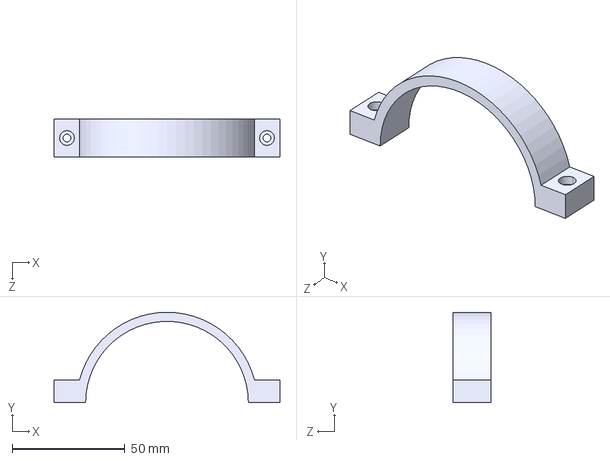
[picture p36: CAD file, 2024-09-07]
solid files/Shaft Holder.STEP
100.0 x 40.0 x 17.0 mm
