farzamjahani/MachineDesign/solid files/Oil Cap Seat.STEP

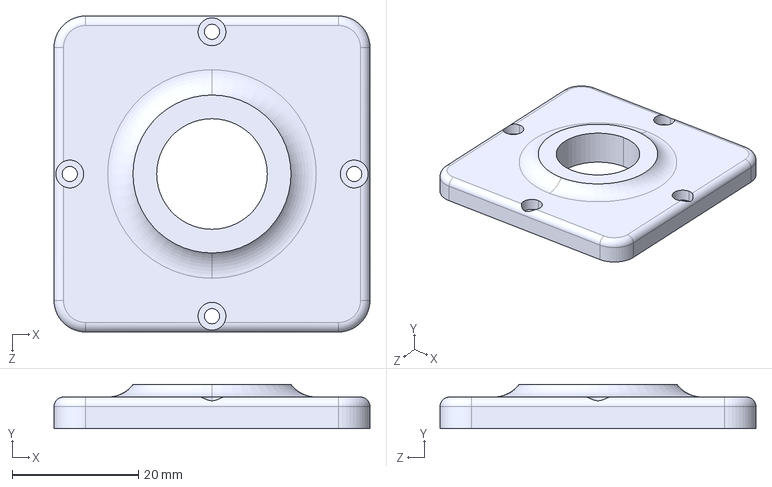
[picture p37: CAD file, 2024-09-07]
solid files/Oil Cap Seat.STEP
50.0 x 7.00 x 50.0 mm
