farzamjahani/MachineDesign/solid files/shaft2.SLDPRT

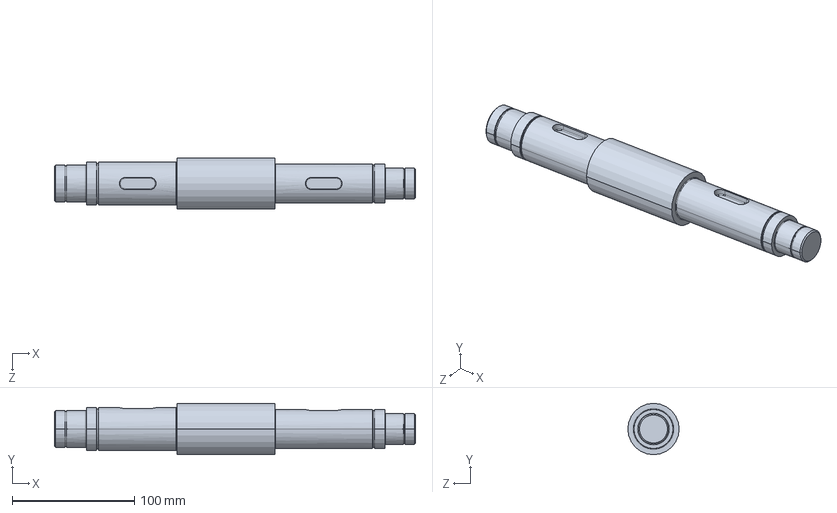
[picture p38: CAD file, 2024-09-07]
solid files/shaft2.SLDPRT
295.0 x 42.0 x 42.0 mm
