farzamjahani/MachineDesign/solid files/shaft1.SLDPRT

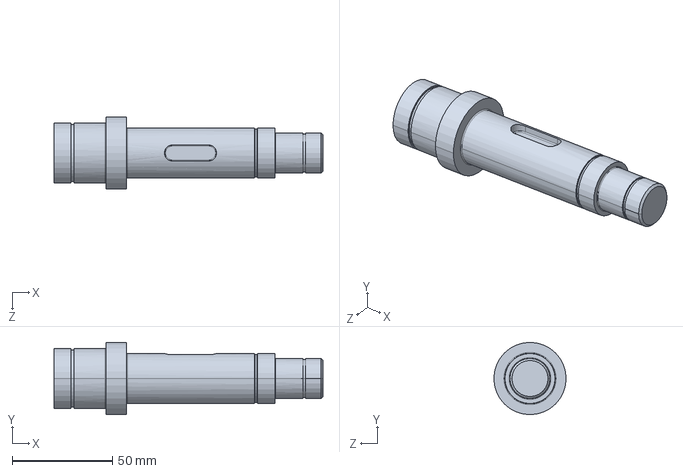
[picture p39: CAD file, 2024-09-07]
solid files/shaft1.SLDPRT
134.0 x 36.0 x 36.0 mm
