farzamjahani/MachineDesign/solid files/Parallel key A10 x 8 x 30 DIN 6885.STEP

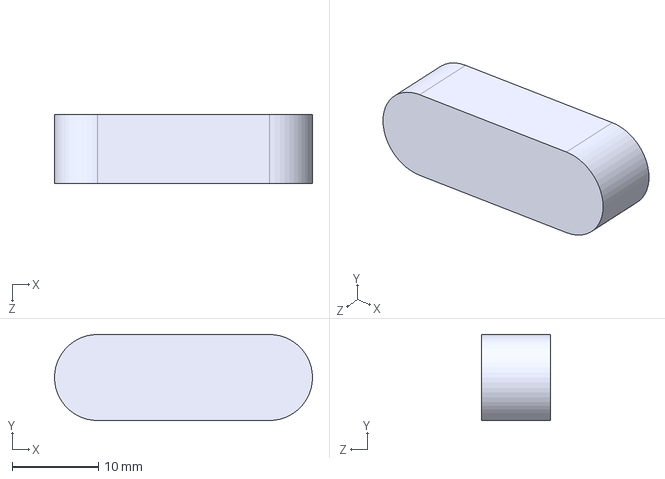
[picture p40: CAD file, 2024-09-07]
solid files/Parallel key A10 x 8 x 30 DIN 6885.STEP
30.0 x 10.0 x 8.00 mm
