farzamjahani/MachineDesign/solid files/socket head cap screw_din.STEP

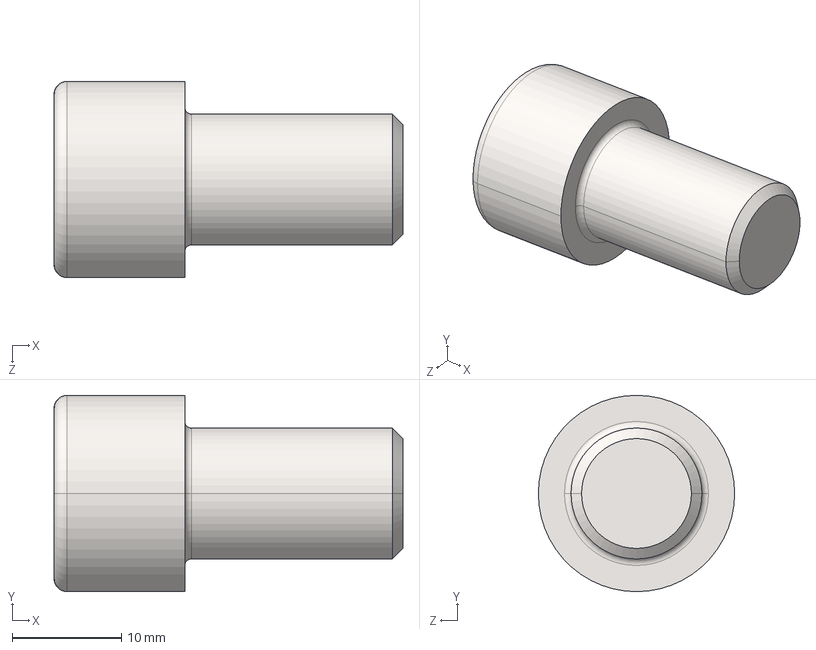
[picture p41: CAD file, 2024-09-07]
solid files/socket head cap screw_din.STEP
32.0 x 18.0 x 18.0 mm
