farzamjahani/MachineDesign/matlab files/DGBB_GuideTable.txt

0.172	0.19	0.56	2.3
0.345	0.22	0.56	1.99
0.689	0.26	0.56	1.71
1.03	0.28	0.56	1.55
1.38	0.3	0.56	1.45
2.07	0.34	0.56	1.31
3.45	0.38	0.56	1.15
5.17	0.42	0.56	1.04
6.89	0.44	0.56	1
