farzamjahani/MachineDesign/matlab files/StaticStressConStep.txt

1.1	2.35	1.7
1.2	2.5	2
1.3	2.55	2.15
1.4	2.64	2.2
1.5	2.77	2.23
